rohamid/h743-lcd-dev/doc/H743_LCD_dev.pdf

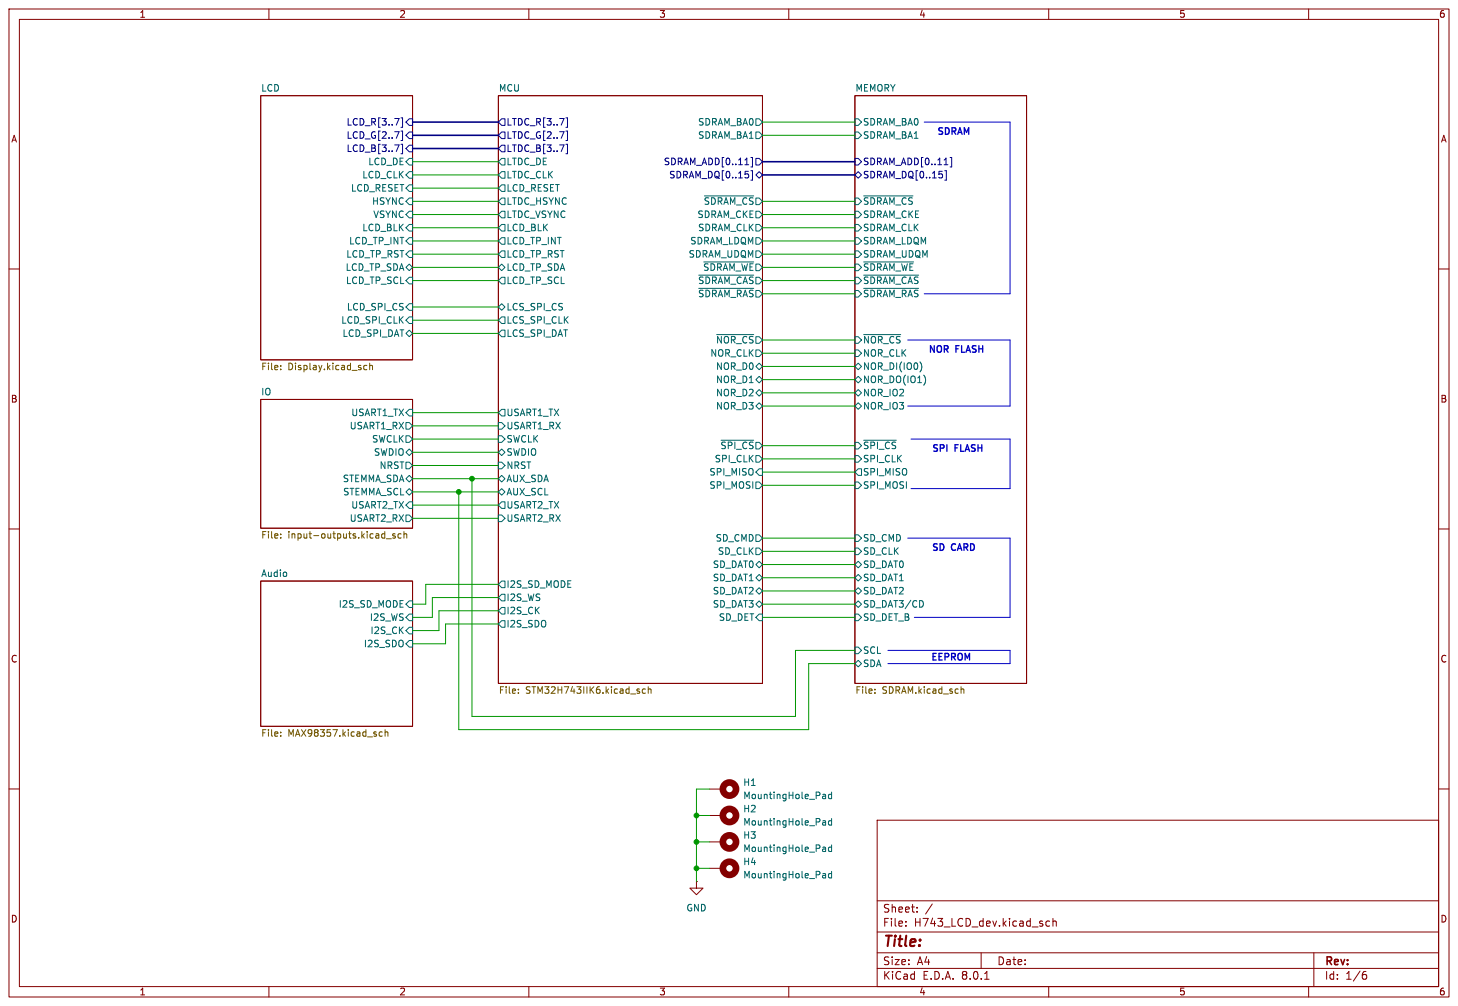
[picture p1: page 1]

Id: 1/6 Title: File: H743_LCD_dev.kicad_sch Sheet: /

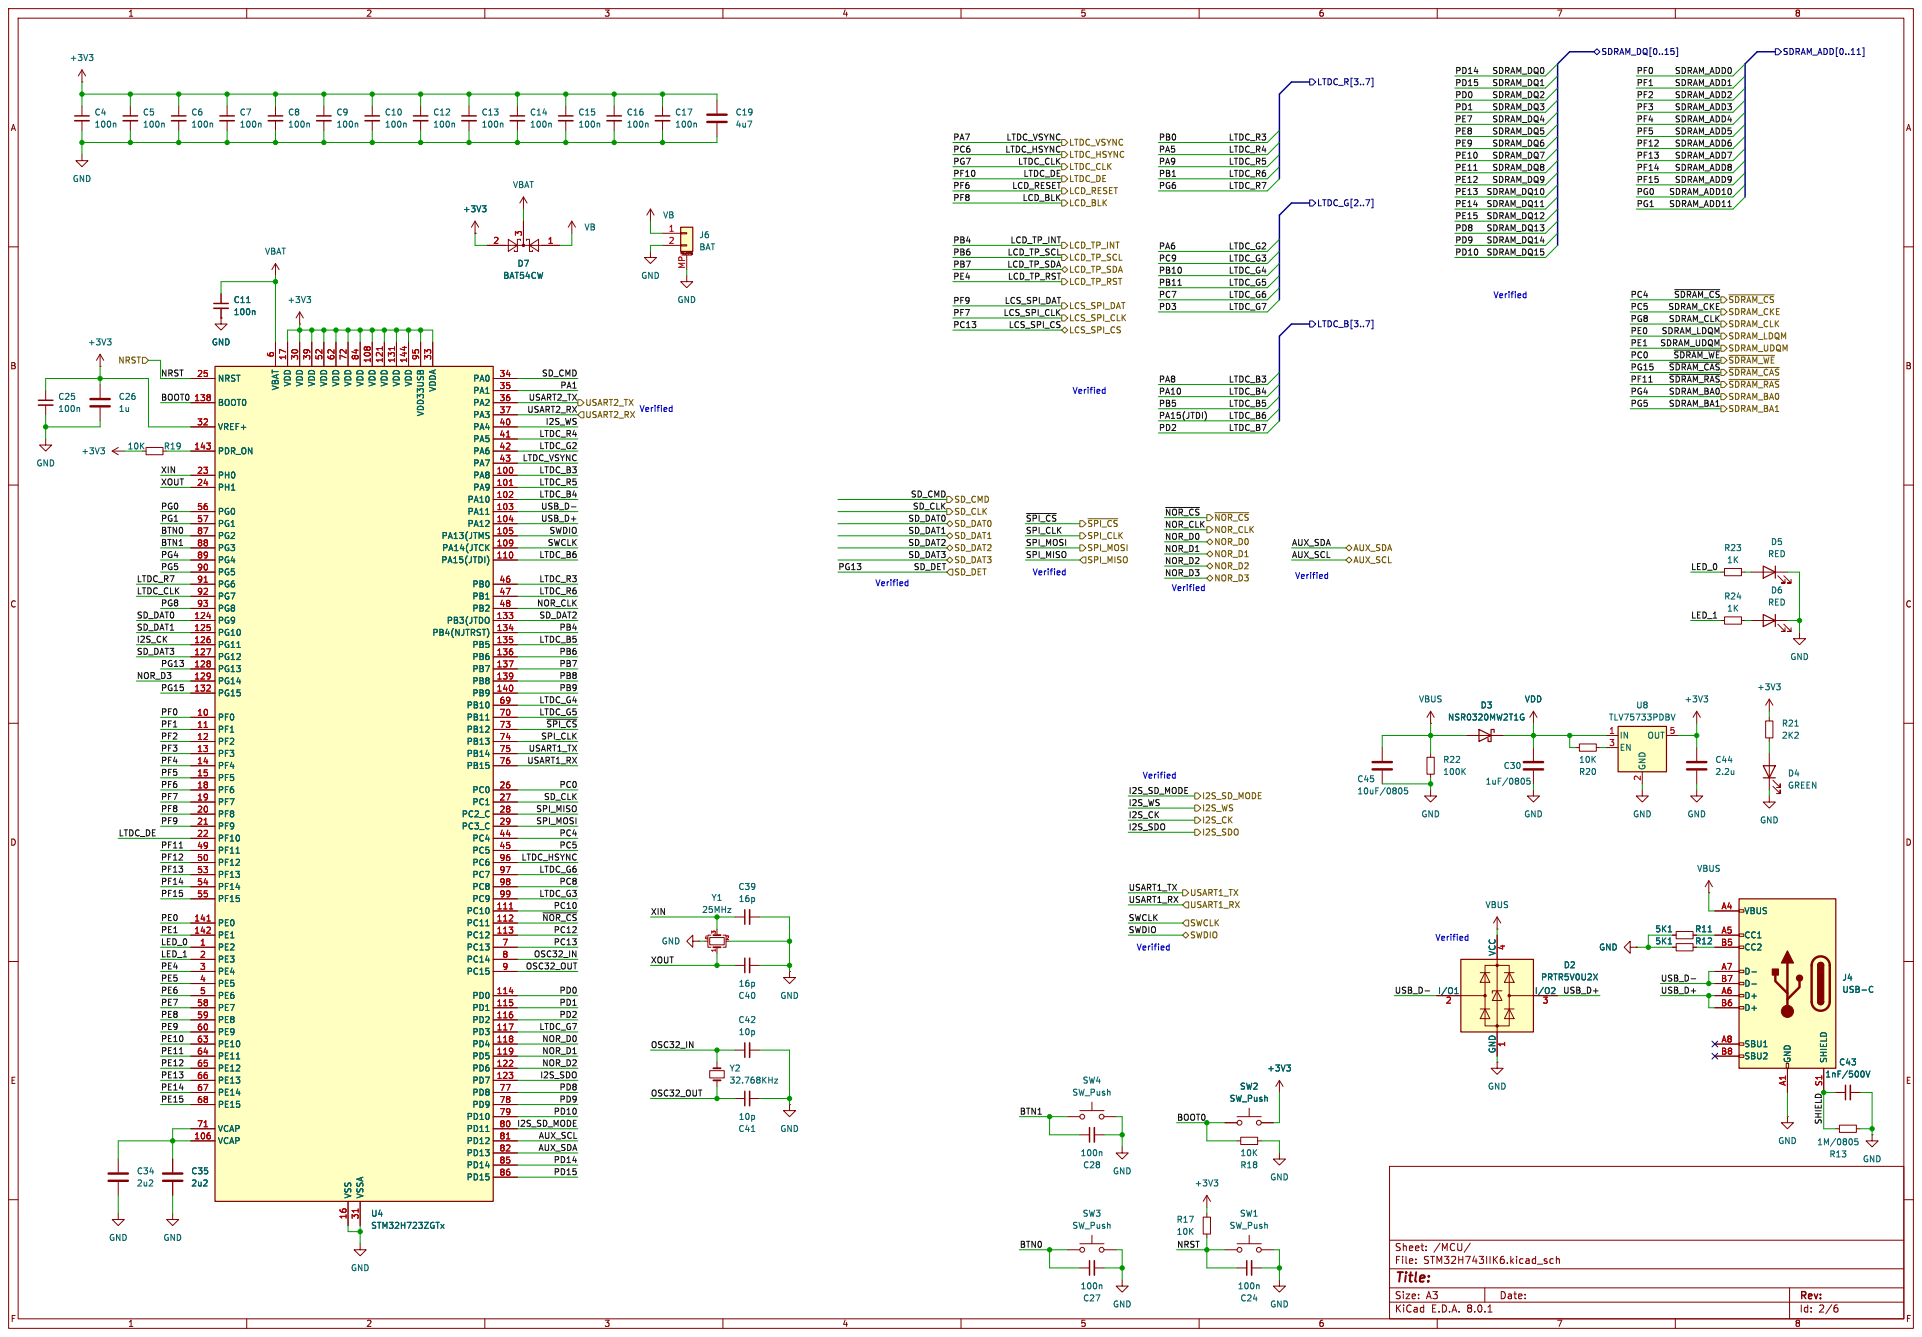
[picture p2: page 2]

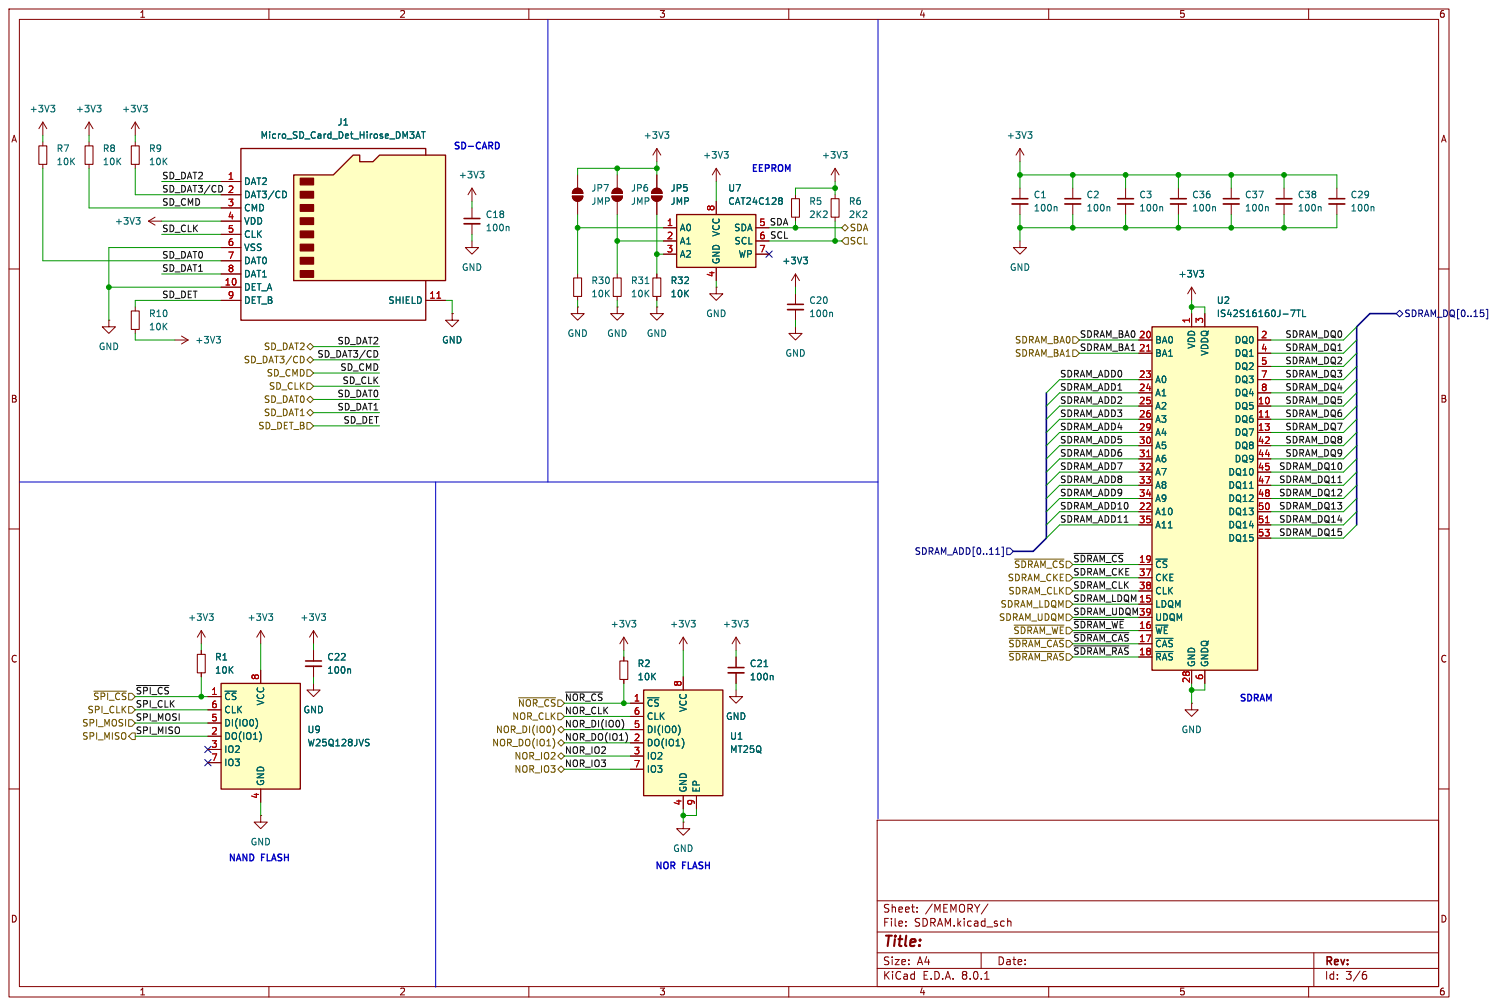
[picture p3: page 3]

4 SDA 5 SCL 6 WP 7 VCC

3 A5 30 A6 31 A7 32 A8 33 A9 34 A11 35 CKE 37 CLK 38 UDQM 39 DQ1 4 DQ8 42 DQ9 44 DQ10 45 DQ11 47 DQ12 48 DQ2 5 DQ13 50 DQ14 51 DQ15 53 GNDQ

Id: 3/6 Title: File: SDRAM.kicad_sch Sheet: /MEMORY/

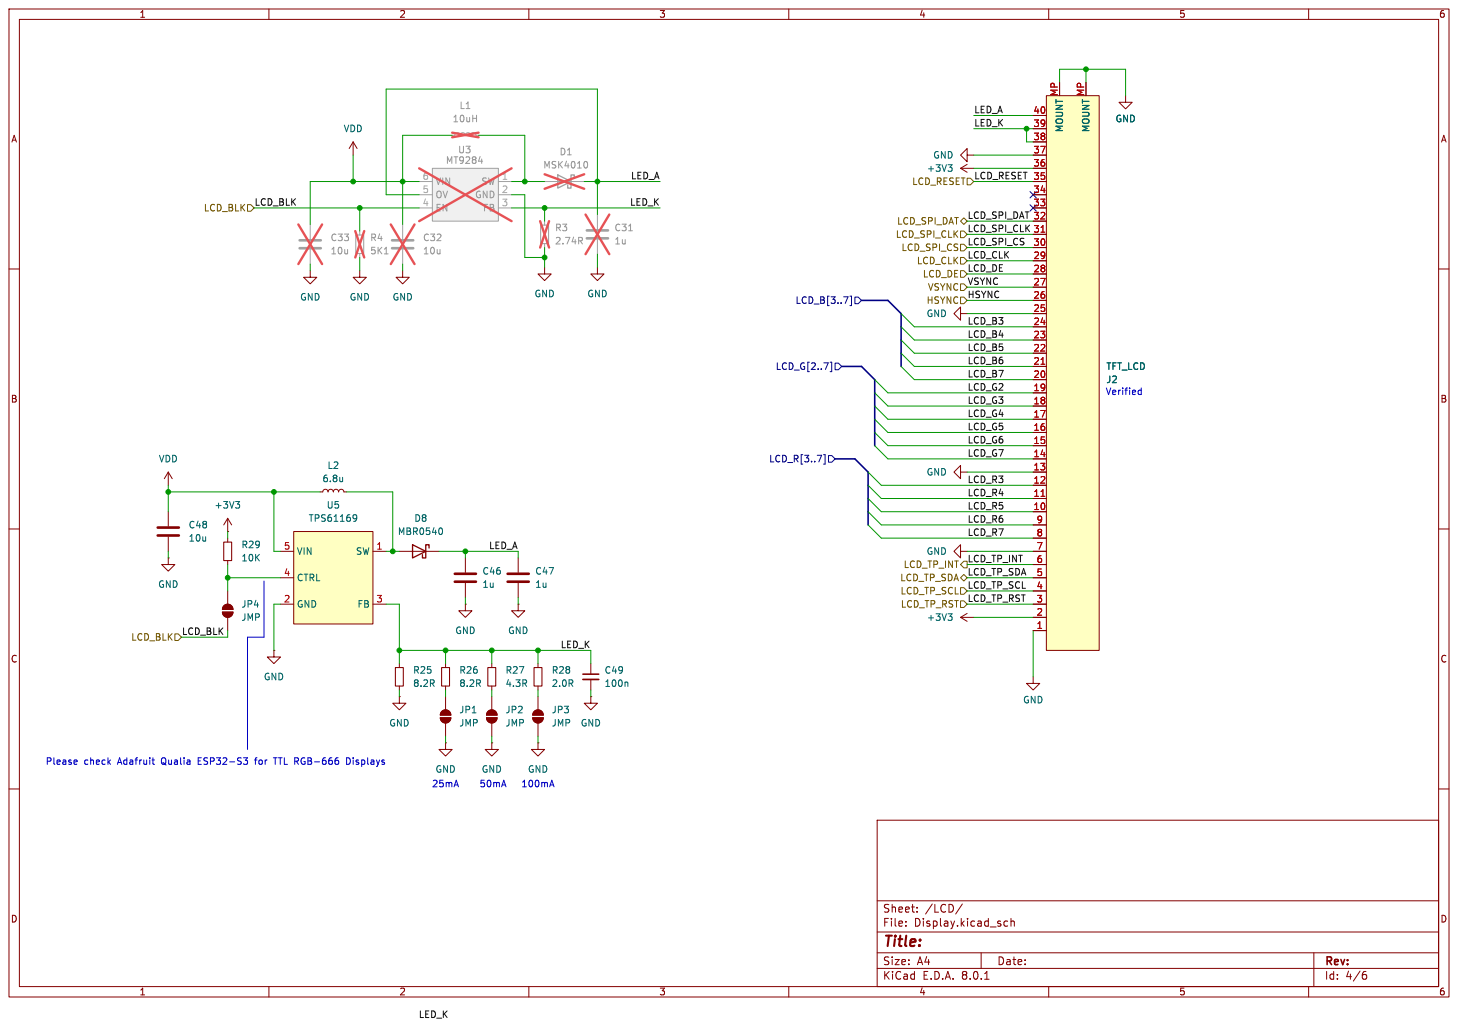
[picture p4: page 4]

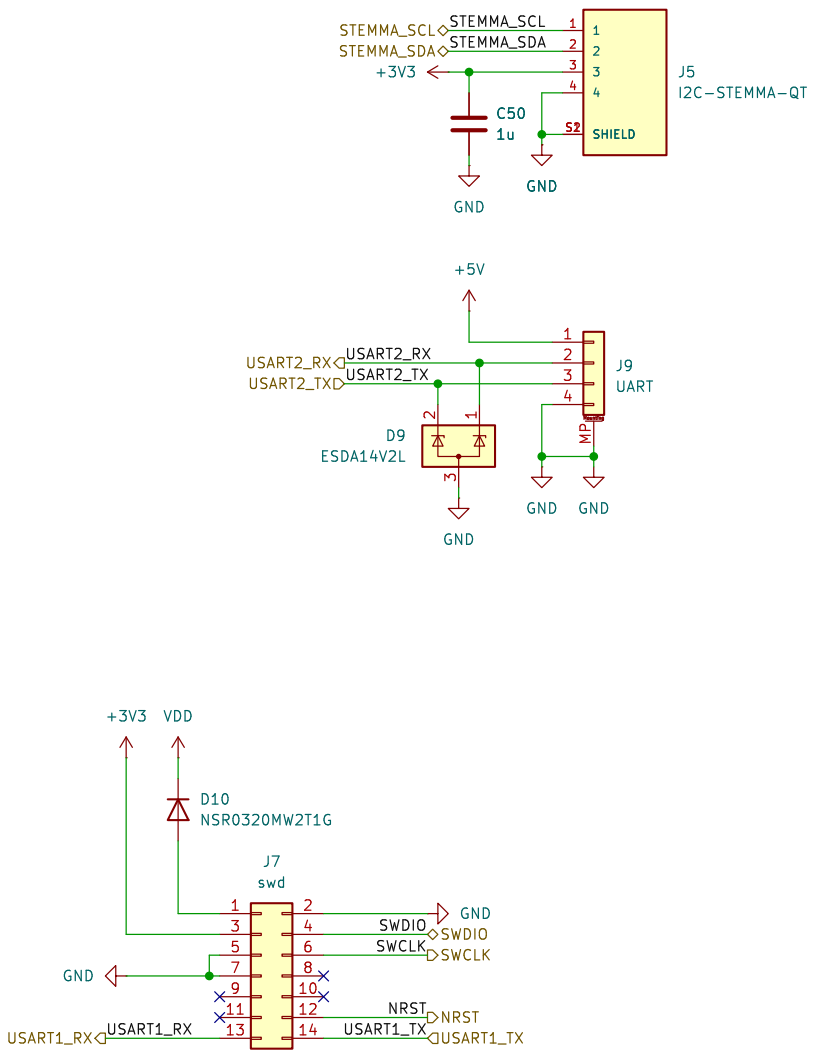
[picture p5: page 5]

Id: 5/6 Title: File: input-outputs.kicad_sch Sheet: /IO/

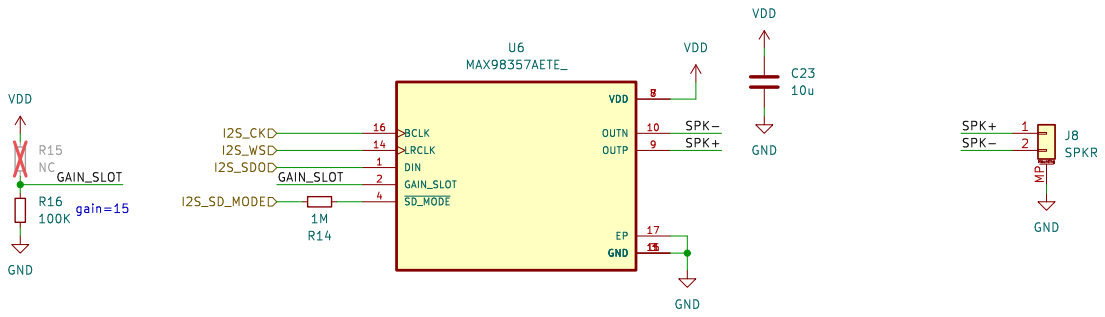
[picture p6: page 6]

Id: 6/6 Title: File: MAX98357.kicad_sch Sheet: /Audio/ GND
