rohamid/h743-lcd-dev/doc/STM32U5G9ZJT6Q Discovery.pdf

Title: Project_Overview

Size:

Reference:
A4 | Sheet: | of

Revision:

Project: STM32U5G9ZJT6Q Discovery

C 01 | MB1918
2023-07-05

U5G9ZJQ

Date:

Variant:

Table of contents | Legend

General comment such as function title, configuration, ...

Text to be added to silkscreen.

# STM32U5G9ZJT6Q Discovery

MB1918

Warning text.

# Open Platform License Agreement

The Open Platform License Agreement (“Agreement”) is a binding legal contract between you ("You")

and STMicroelectronics International N.V. (“ST”), a company incorporated under the laws of the

Netherlands acting for the purpose of this Agreement through its Swiss branch 39, Chemin du

Champ des Filles, 1228 Plan-les-Ouates, Geneva, Switzerland.

By using the enclosed reference designs, schematics, PC board layouts, and documentation, in hardcopy

or CAD tool file format (collectively, the “Reference Material”), You are agreeing to be bound by

the terms and conditions of this Agreement. Do not use the Reference Material until You have read

and agreed to this Agreement terms and conditions. The use of the Reference Material automatically

implies the acceptance of the Agreement terms and conditions.

The complete Open Platform License Agreement can be found on www.st.com/opla.

MB1918TOP

MB1918_TOP.SchDoc

Sheet 1: Project overview (this page)

Sheet 2: MB11918 TOP

Sheet 3: MCU System

Sheet 4: MCU Interfaces

Sheet 5: MCU Power

Sheet 6: Board Power

Sheet 7: Display

Sheet 8: USB Type C

Sheet 9: User Interface

Sheet 10: Octo SPI Flash Memory

Sheet 11: Arduino UNO Rev3Connectors

Sheet 12: STLINK V3EC

Sheet 13: External DebugConnectors

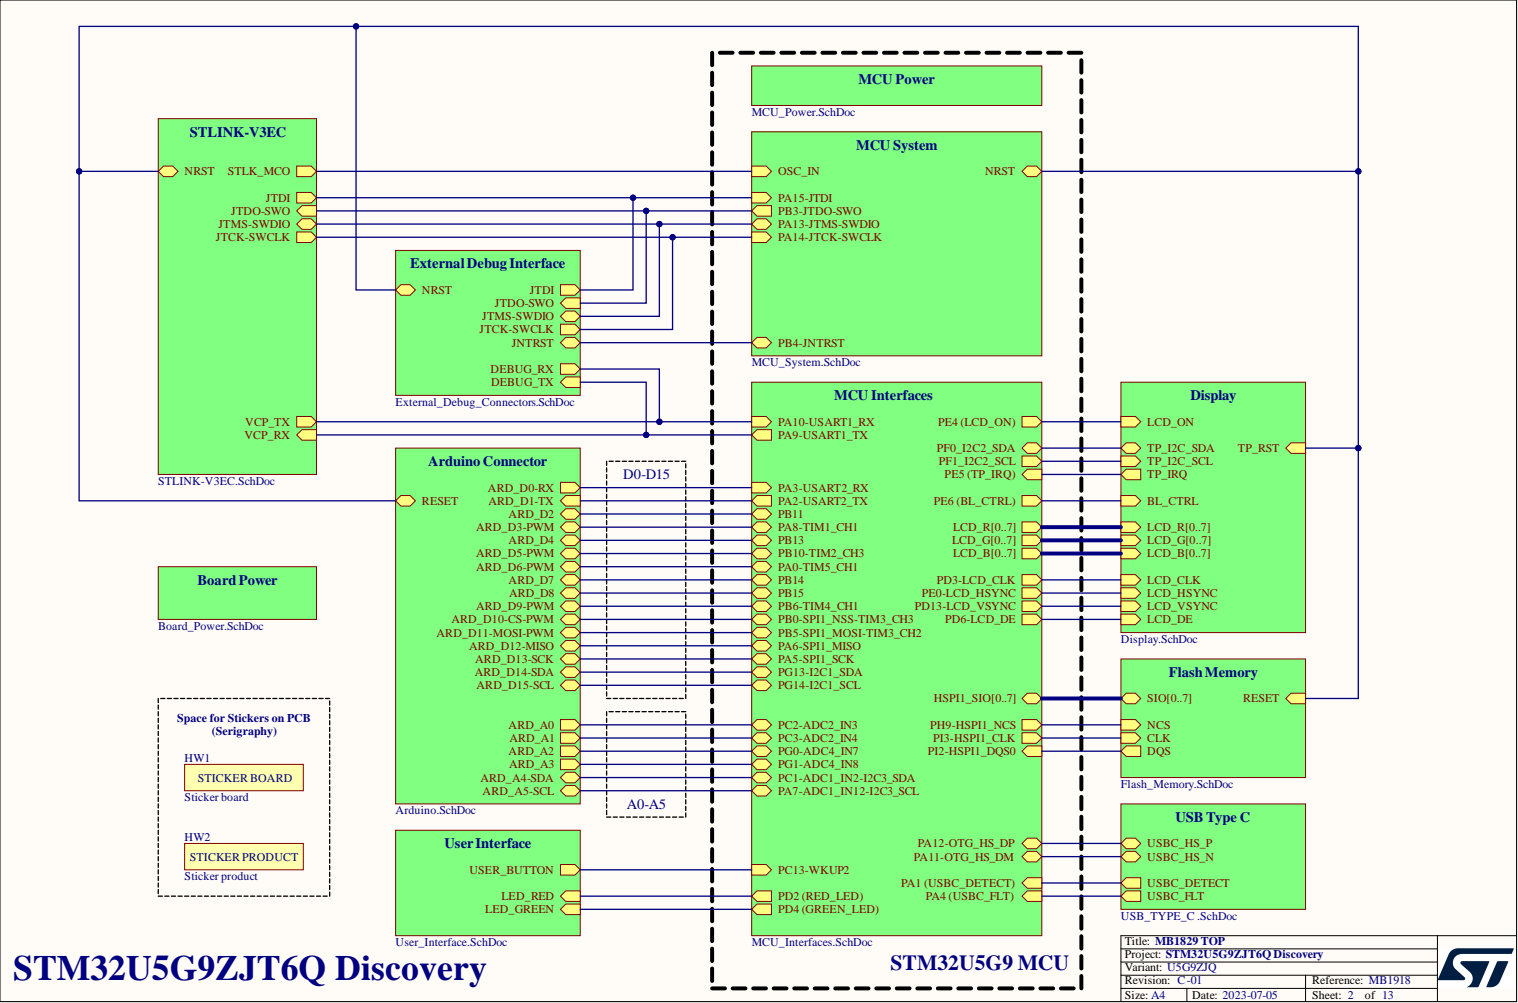
[picture p7: page 2]

Space for Stickers on PCB

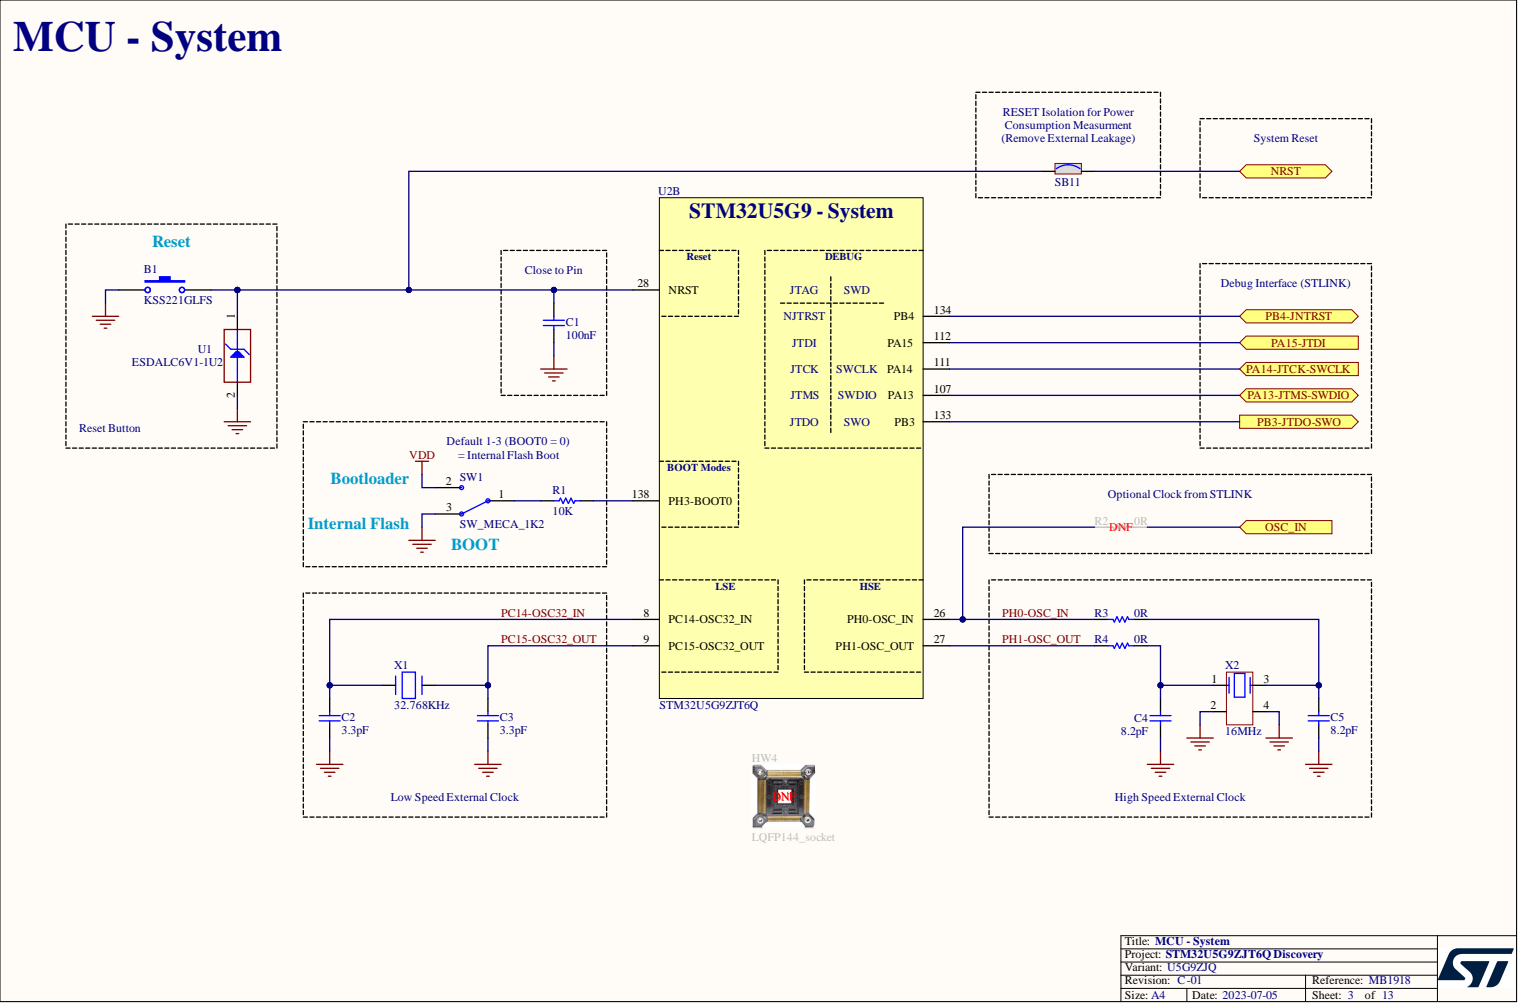
[picture p8: page 3]

RESET Isolation for Power
Consumption Measurment
(Remove External Leakage)

Optional Clock from STLINK

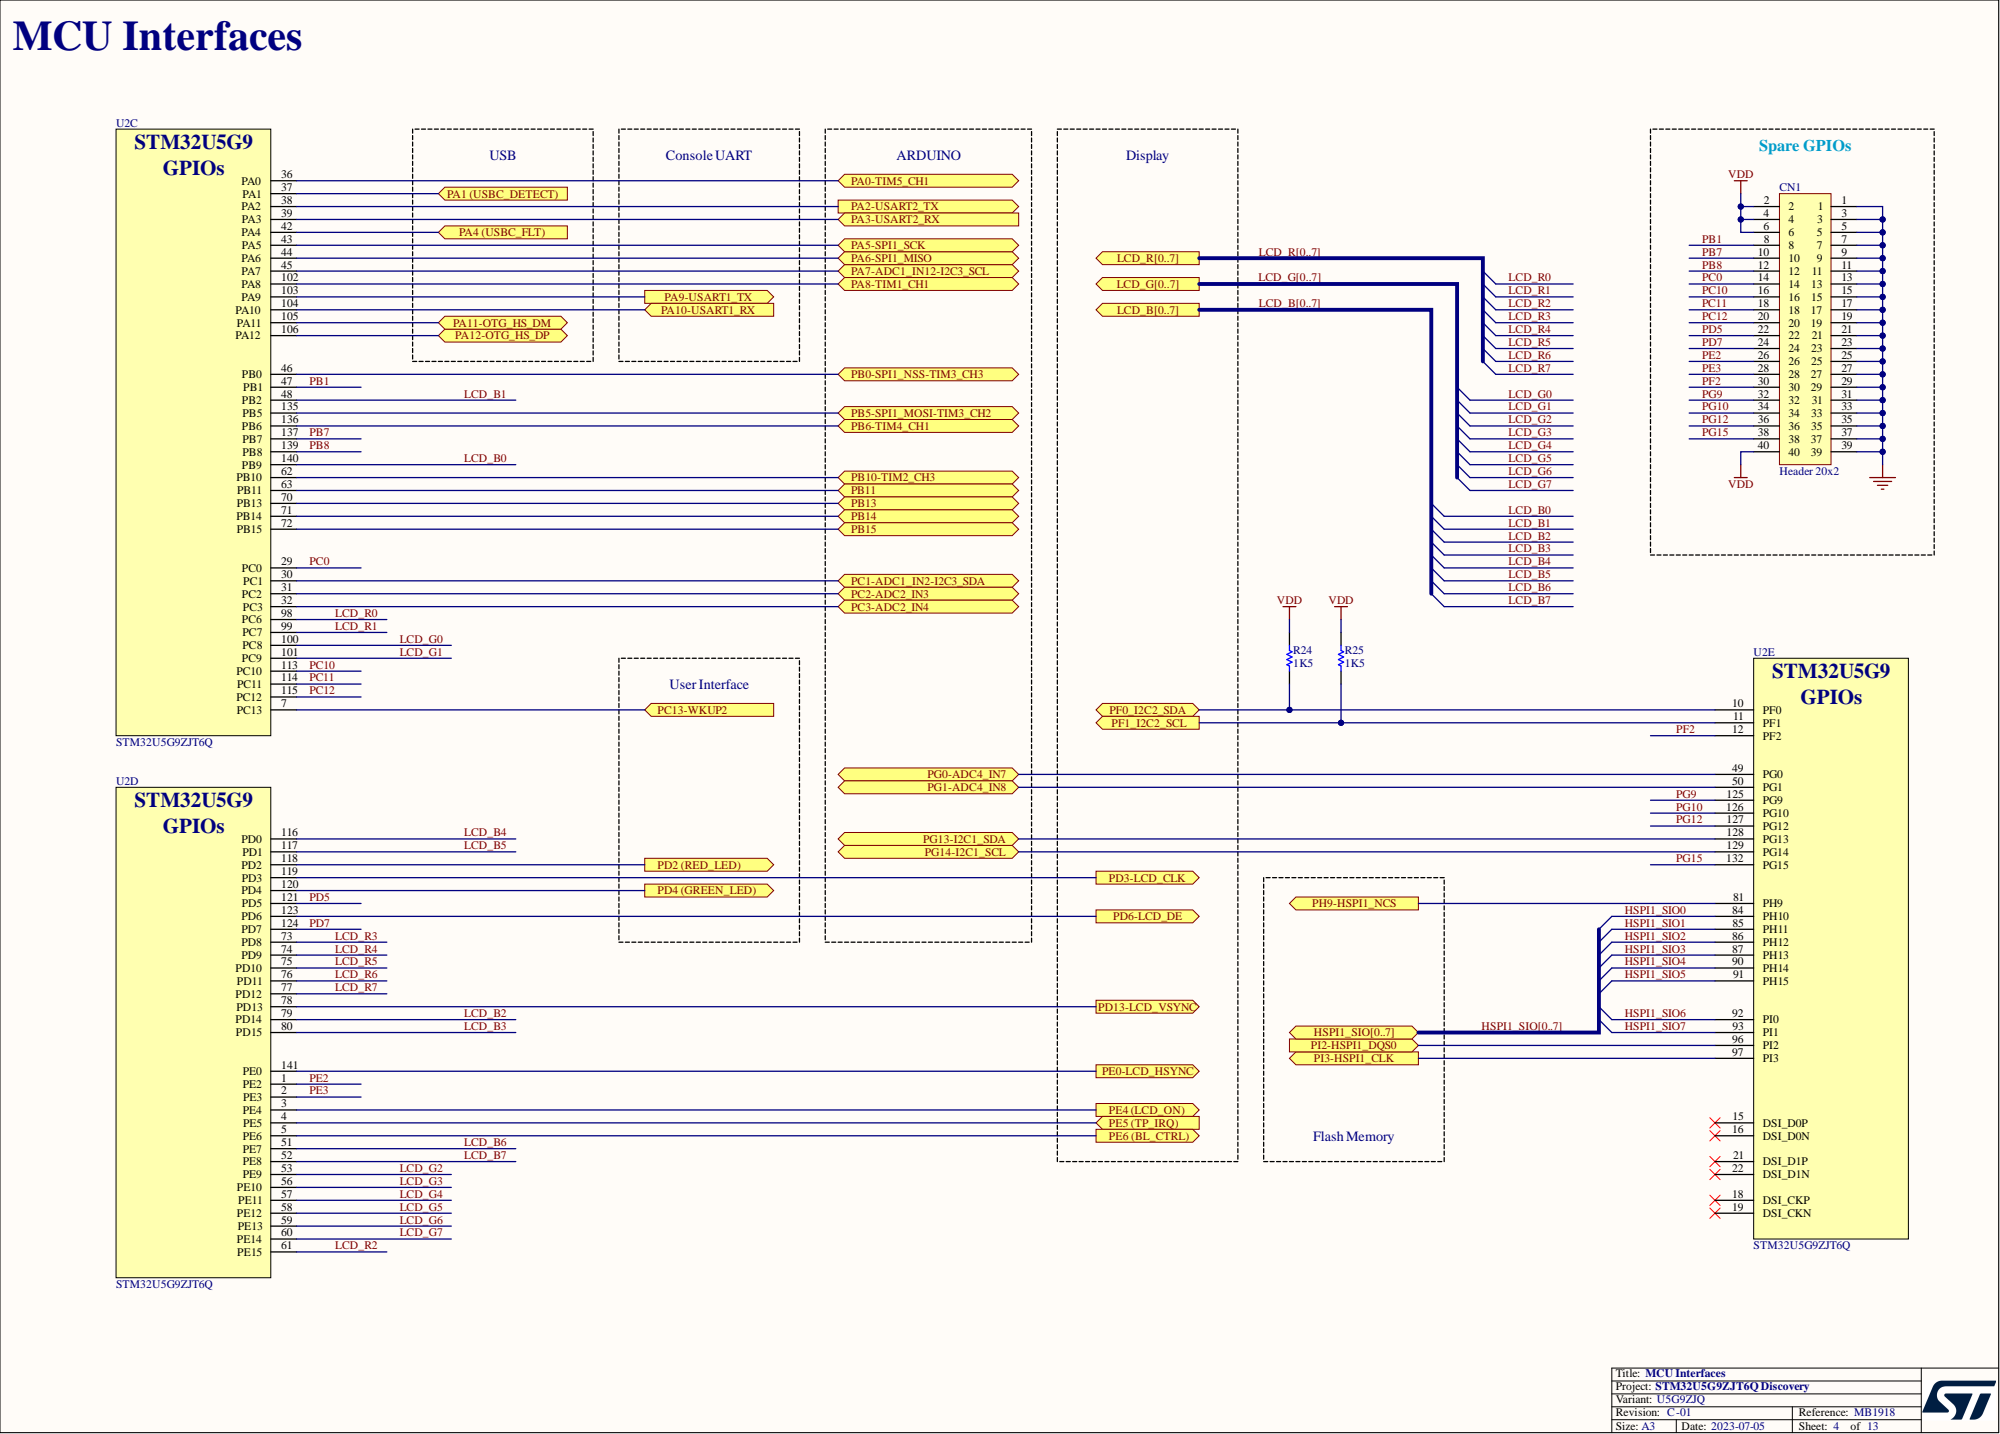
[picture p9: page 4]

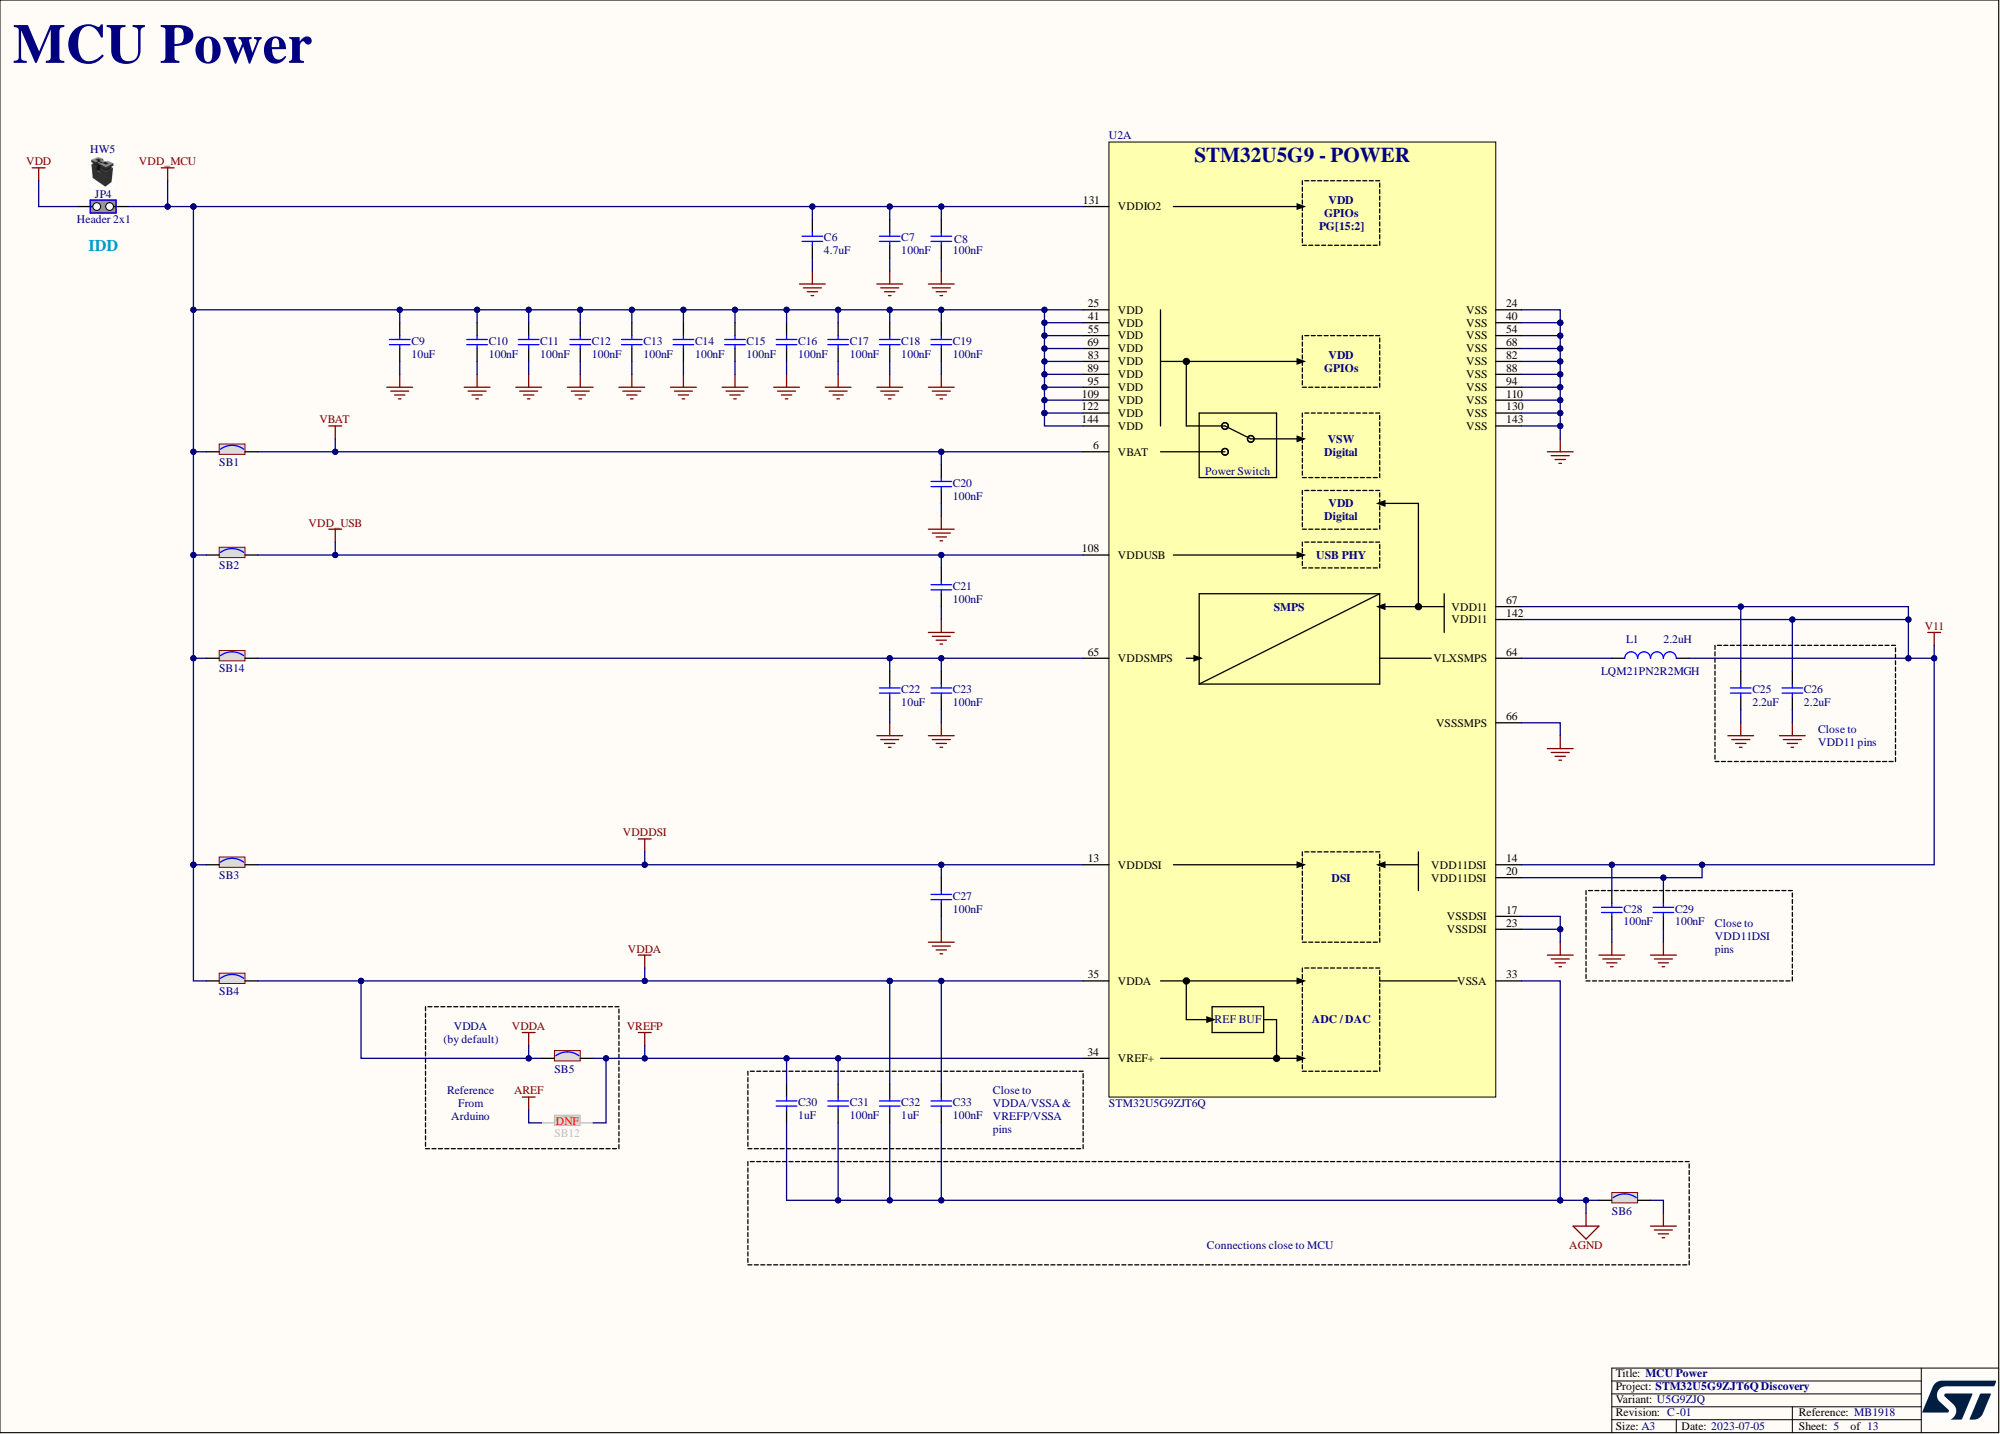
[picture p10: page 5]

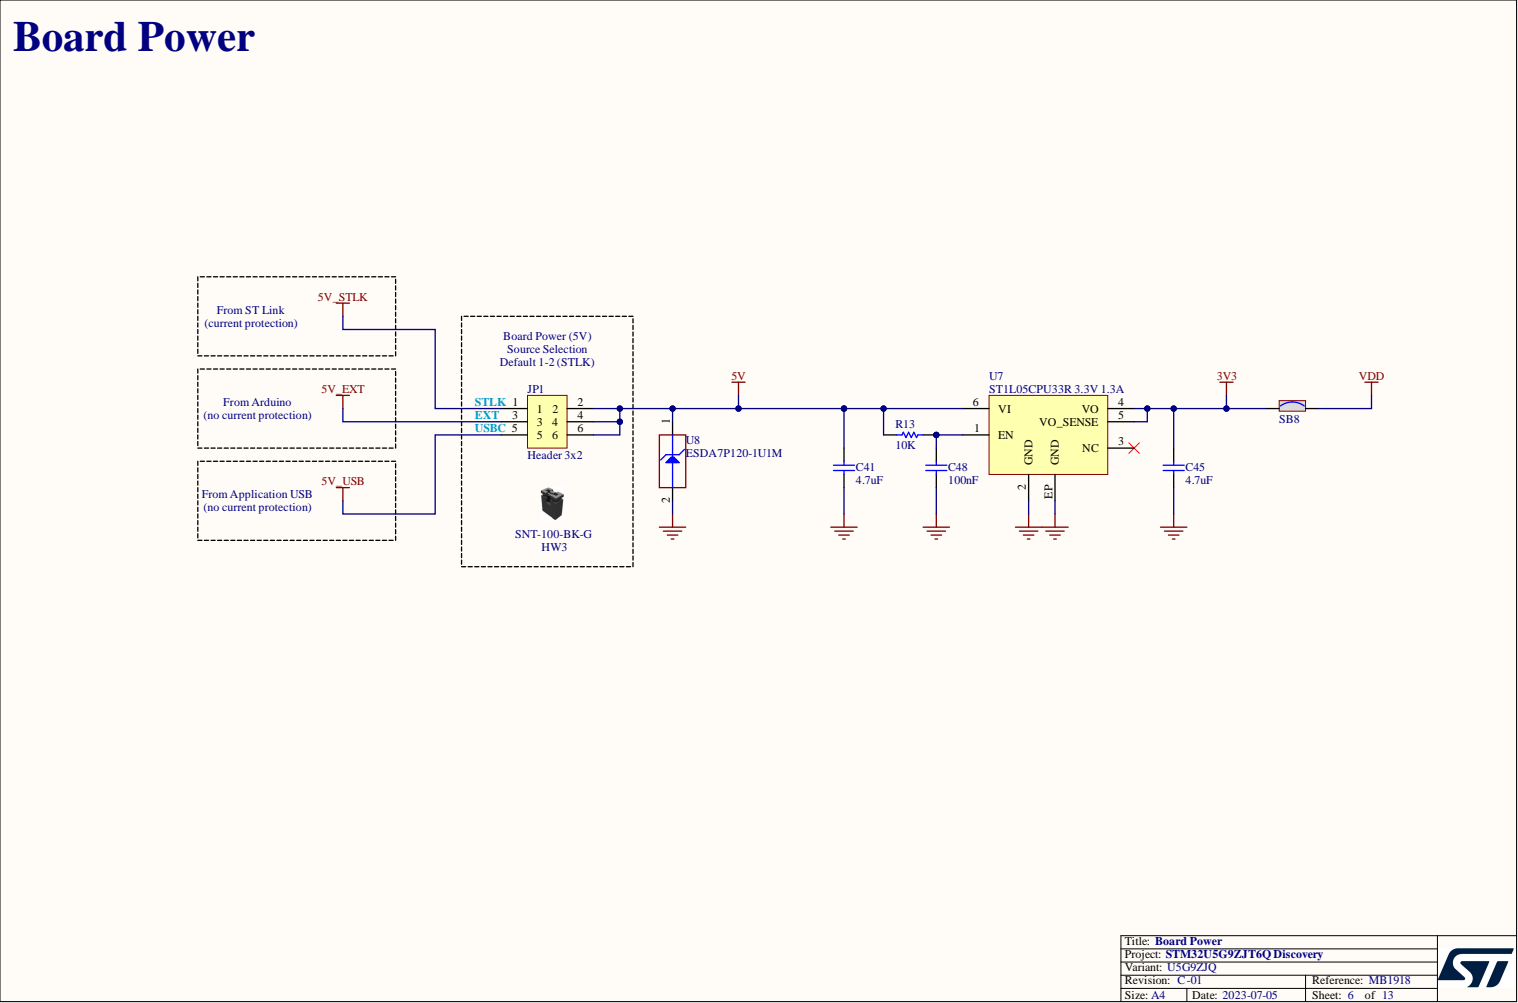
[picture p11: page 6]

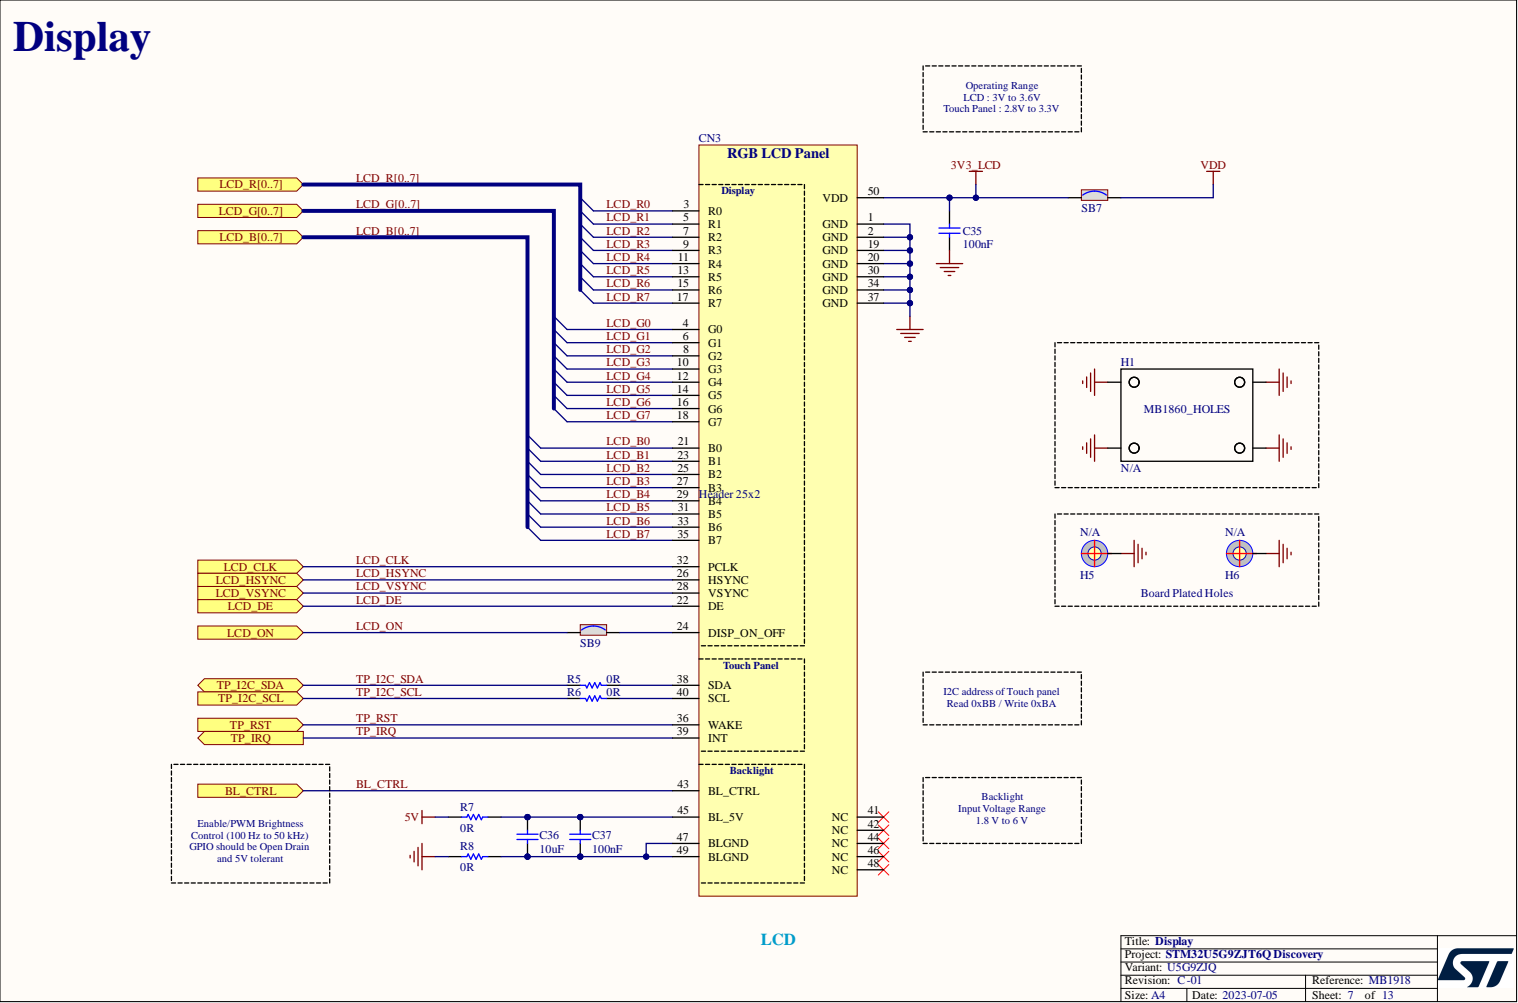
[picture p12: page 7]

PIO should be Open Dra
and 5V tol

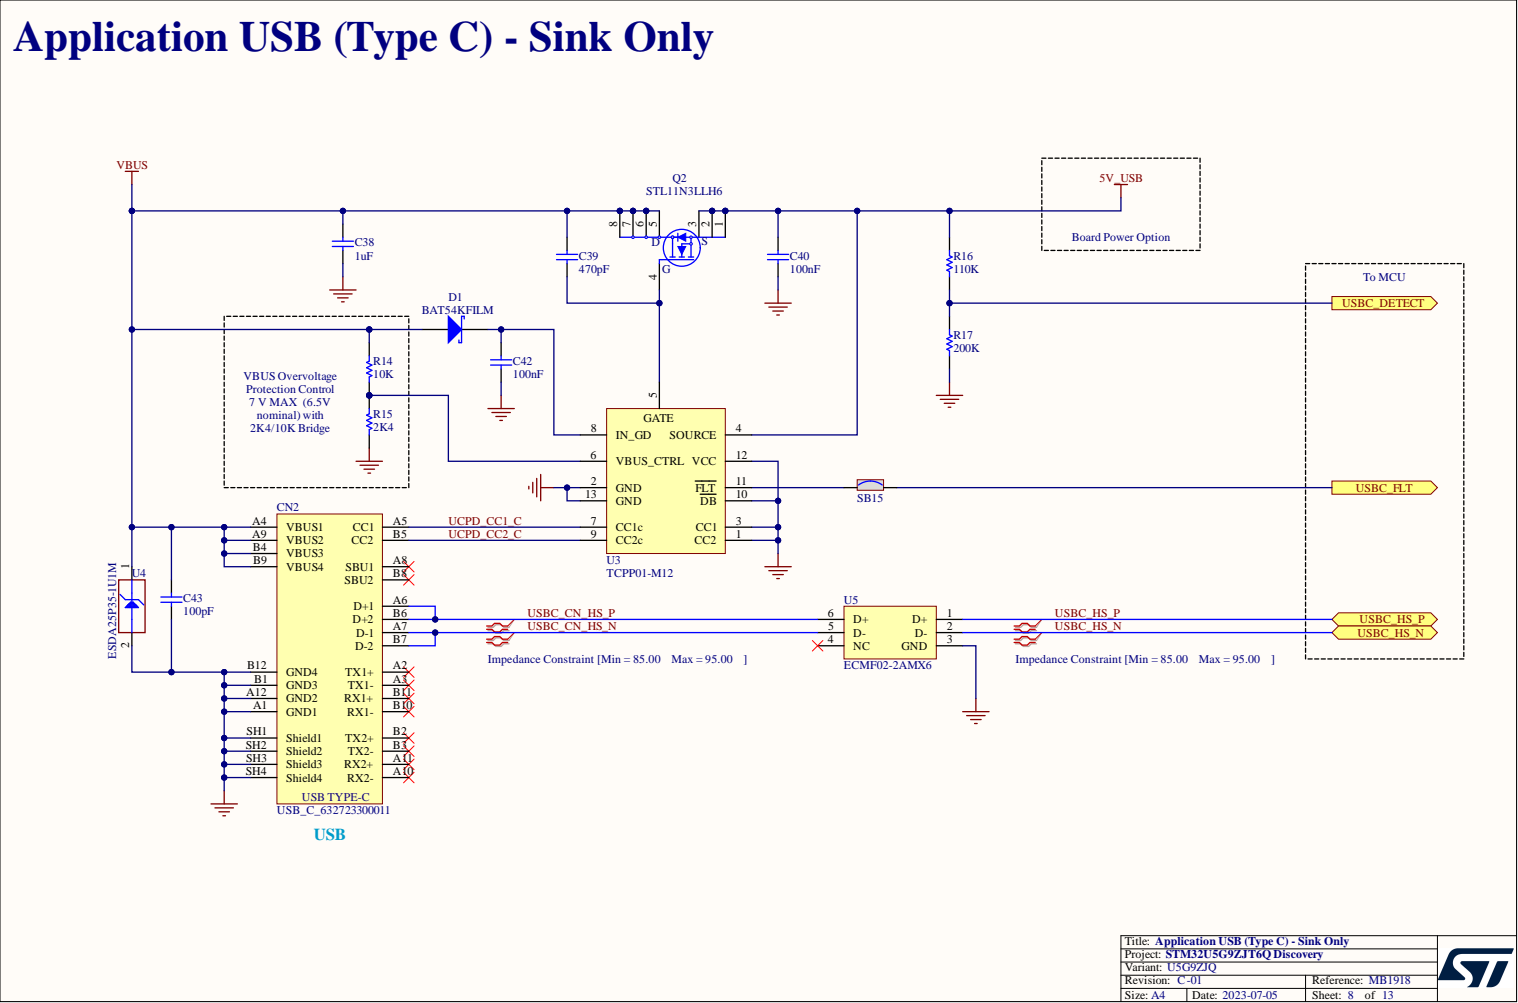
[picture p13: page 8]

Application USB (Type C) - Sink Only

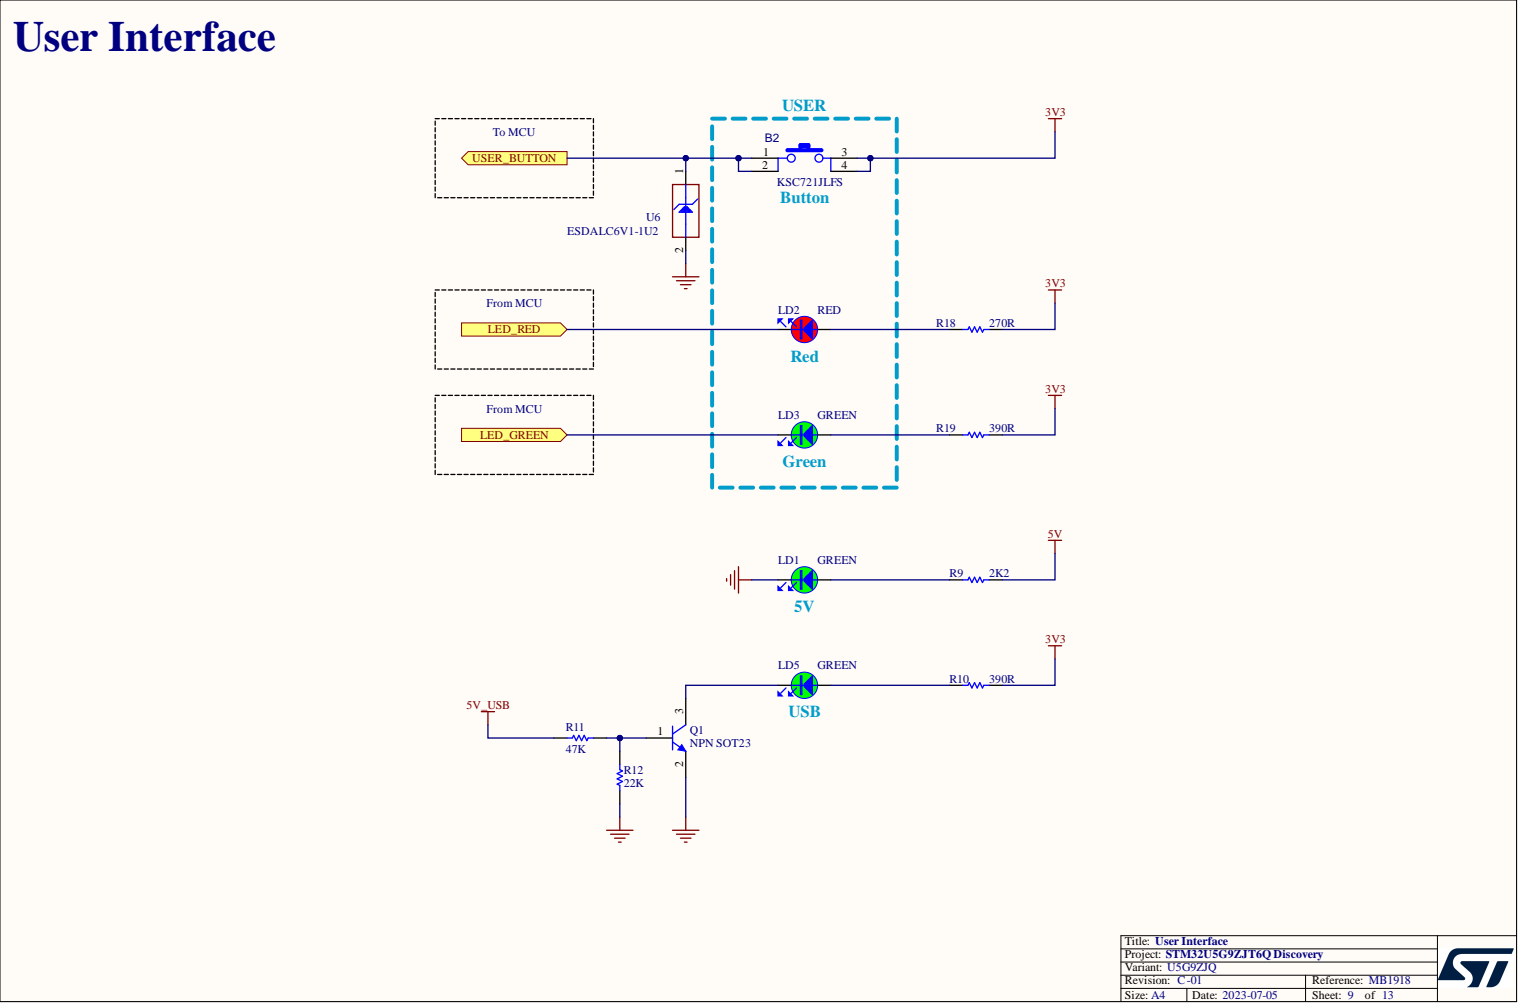
[picture p14: page 9]

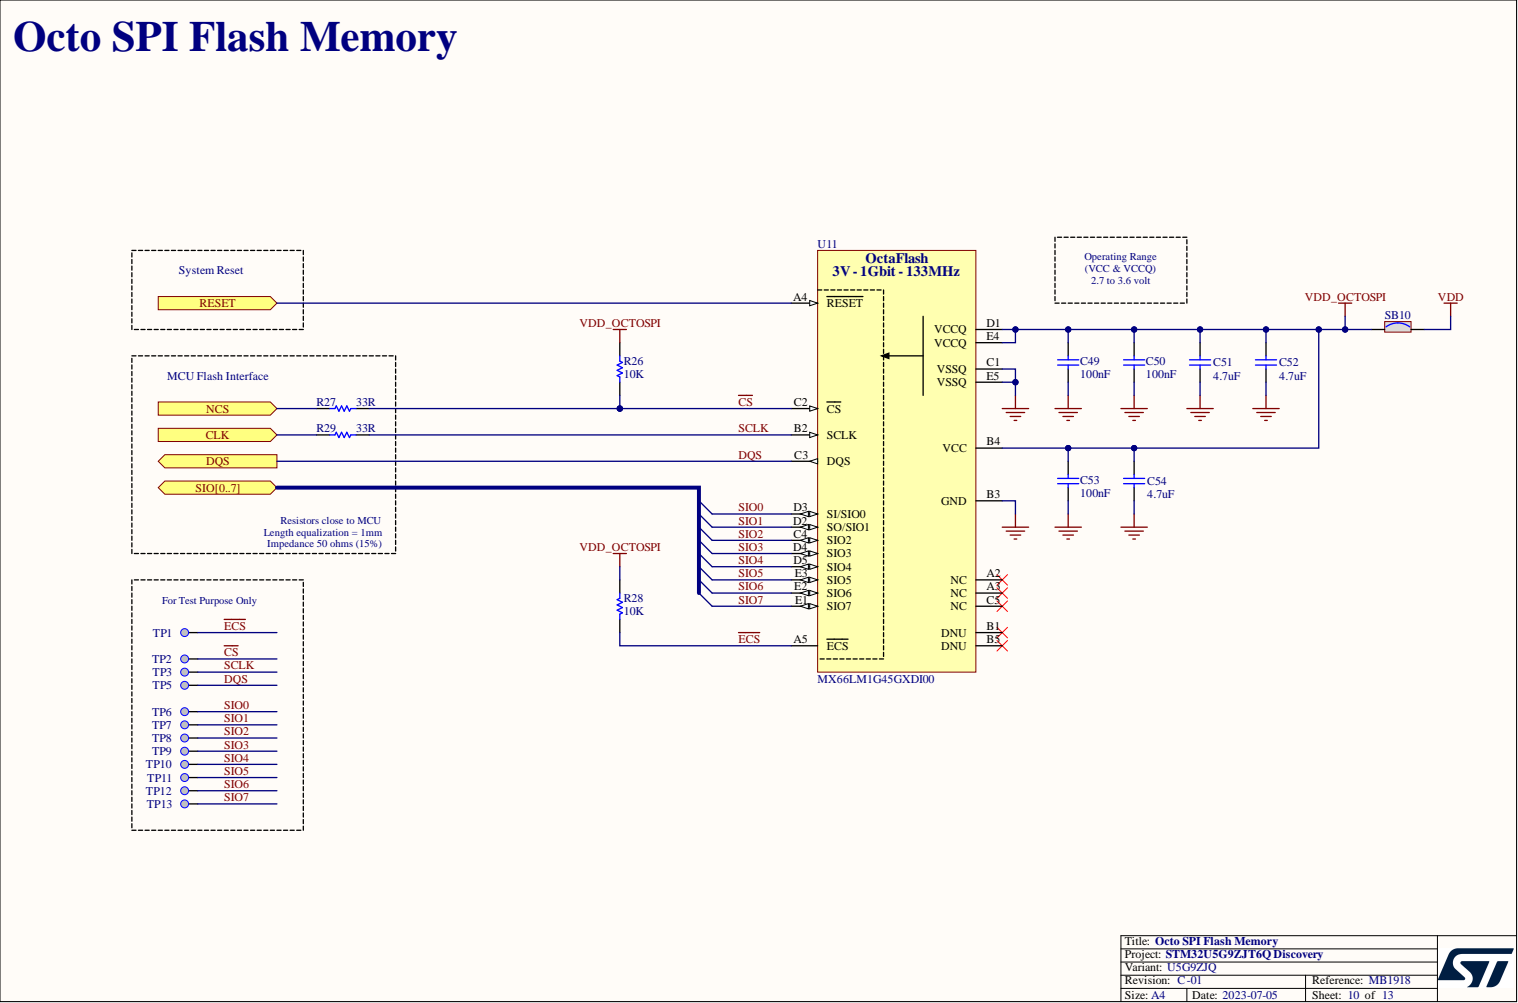
[picture p15: page 10]

Octo SPI Flash Memory

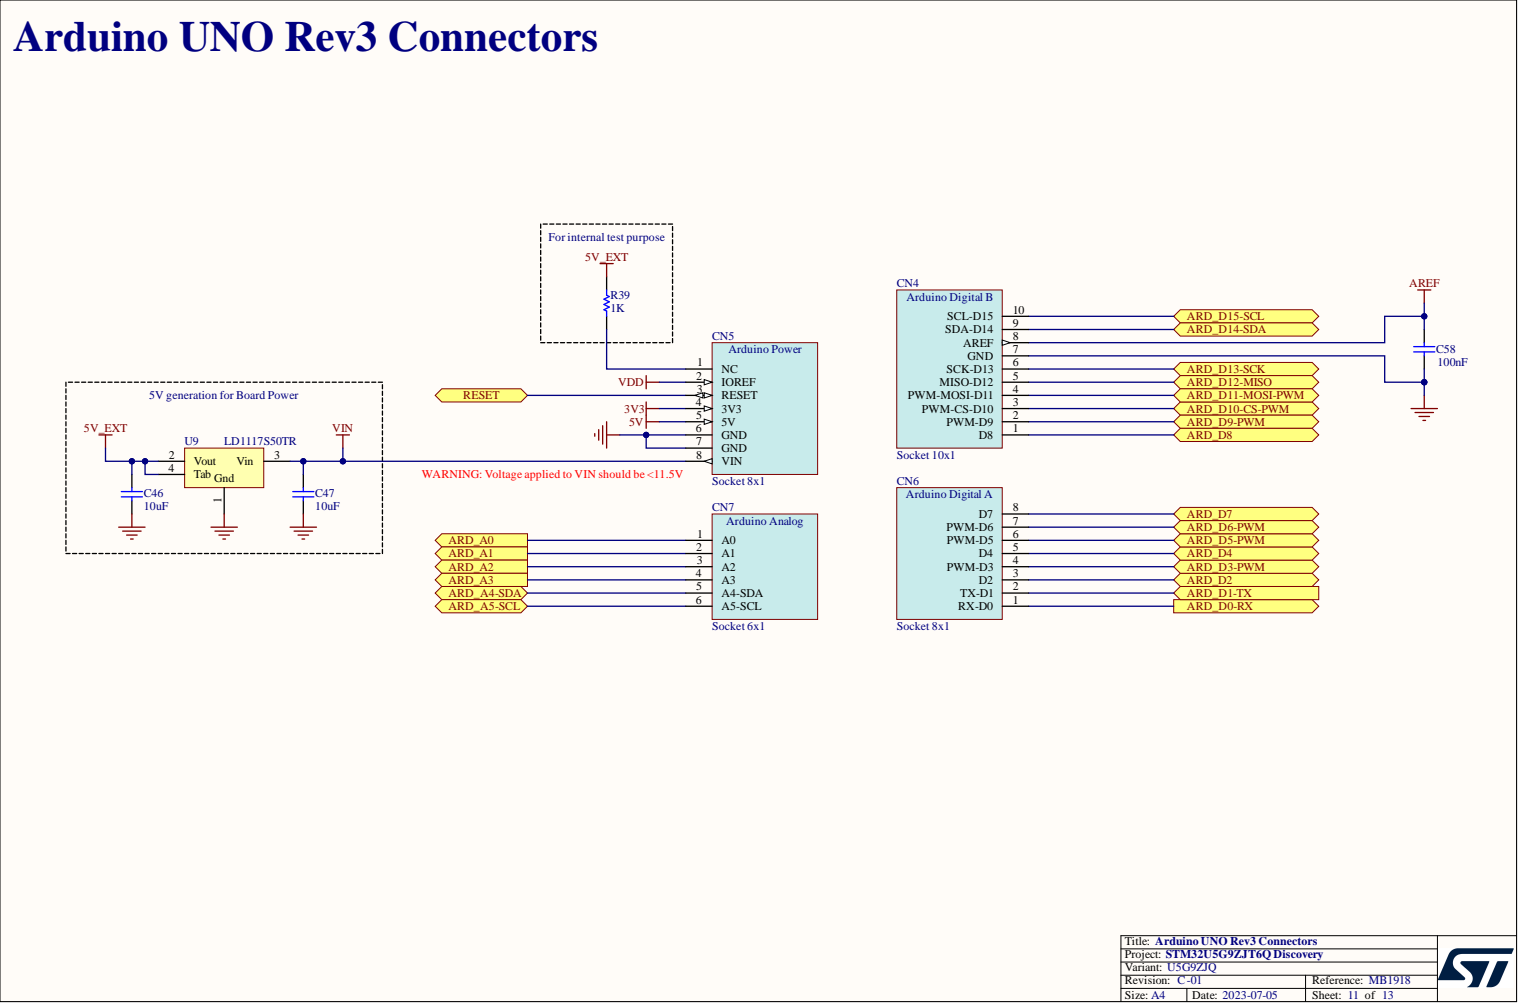
[picture p16: page 11]

Arduino UNO Rev3 Connectors ARD_A0 ARD_A4-SDA ARD_A5-SCL ARD_A1 ARD_A2 ARD_A3

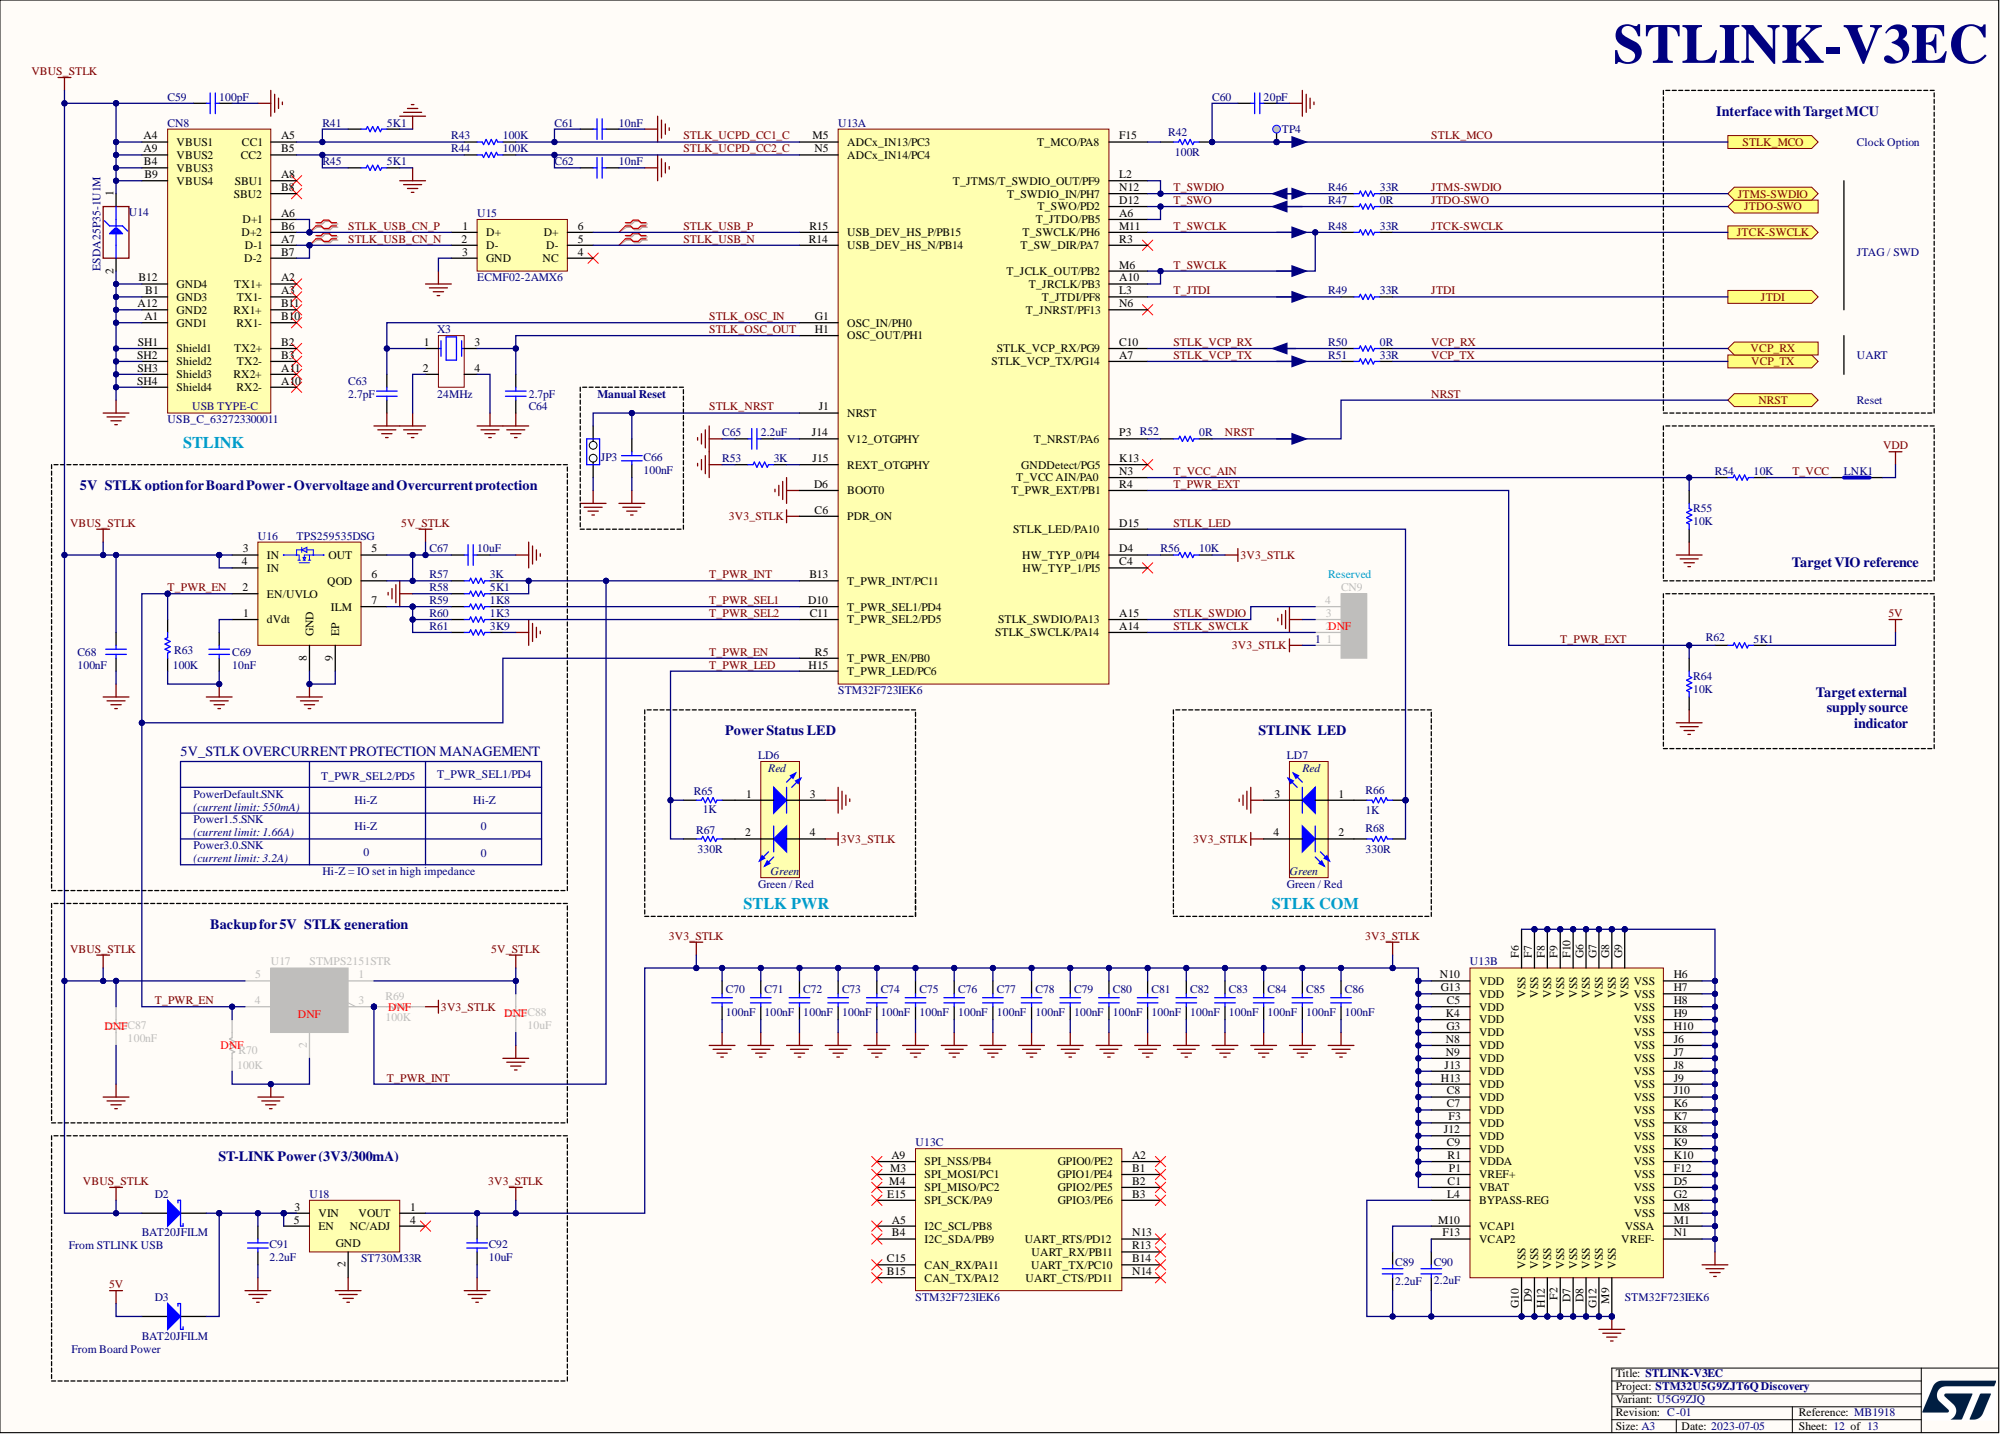
[picture p17: page 12]

VBUS2 A9 | R44 100K STLK_UCPD_CC2_C | ADCx_IN14/PC4 N5

V12_OTGPHY J14

5V_STLK option forBoardPower - Overvoltage andOvercurrent protection

C68 | T_PWR_EN | IN 4 | R57 3K

Reserved CN9

R58 5K1 | | T_PWR_SEL1 | T_PWR_SEL1/PD4 D10
R60 | 1K3 | T_PWR_SEL2 | T_PWR_SEL2/PD5 C11 | | | 1 1 2 2 3 3 4 4

R61 | 3K9 | | T_PWR_EN | T_PWR_EN/PB0 R5 | | STLK_SWCLK | DNF

PowerDefault.SNK (current limit: 550mA) | Hi-Z | Hi-Z

Power1.5.SNK (current limit: 1.66A) | Hi-Z | 0

Hi-Z = IO set in high impedance

VSS M9 VSS G12 VSS D8 VSS D7 VSS F2 VSS H12 VSS D9 VSS F6

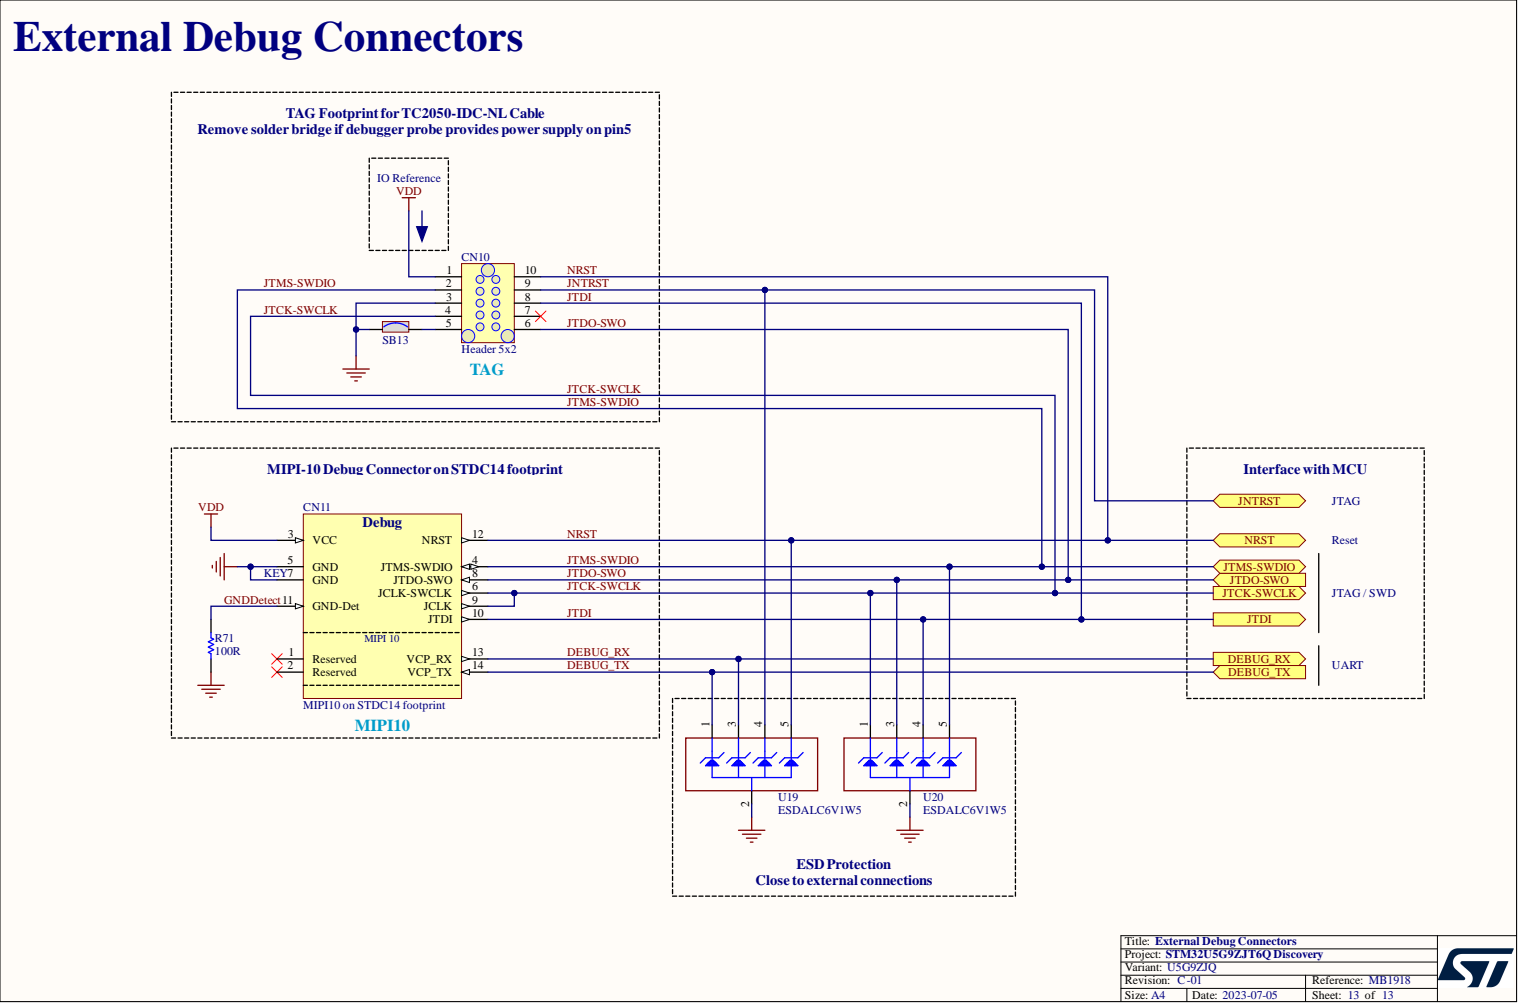
[picture p18: page 13]

TAG Footprint forTC2050-IDC-NL Cable

Remove solder bridge if debugger probe provides power supply on pin5

JNTRST

3 | | 8 | JTDI
5 | 6 | JTDO-SWO

MIPI-10 Debug Connector on STDC14 footprint

JTMS-SWDIO

KEY | JCLK-SWCLK JTDO-SWO | 6 GND 7 8 | JTDO-SWO

JTCK-SWCLK

JTDI MIPI 10 VCP_RX VCP_TX | 10 JCLK 9 GND-Det 11 | | JTDI

13 DEBUG_RX

Reserved 2 | 14 DEBUG_TX

Close to external connections

Title: External Debug Connectors
