rohamid/h743-lcd-dev/doc/SCH_MAIN_2023-08-08.pdf

VDD 72 PB12 73 PB13 74 PB14 75 PB15 76 PD8 77 PD9 78 PD10 79 PD11 80 PD12 81 PD13 82 VSS 83 VDD 84 PD14 85 PD15 86 PG2 87 PG3 88 PG4 89 PG5 90 PG6 91 PG7 92 PG8 93 VSS 94 VDD33USB 95 PC6 96 PC7 97 PC8 98 PC9 99 PA8 100 PA9 101 PA10 102 PA11 103 PA12 104 PA13 105 VCAP 106 VSS 107 VDD 108 PA14 109 PA15 110 PC10 111 PC11 112 PC12 113 PD0 114 PD1 115 PD2 116 PD3 117 PD4 118 PD5 119 VSS 120 VDD 121 PD6 122 PD7 123 PG9 124 PG10 125 PG11 126 PG12 127 PG13 128 PG14 129 VSS 130 VDD 131 PG15 132 PB3 133 PB4 134 PB5 135 PB6 136 PB7 137 BOOT0 138 PB8 139 PB9 140 PE0 141 PE1 142 PDR_ON 143 VDD 144

# SDRAM

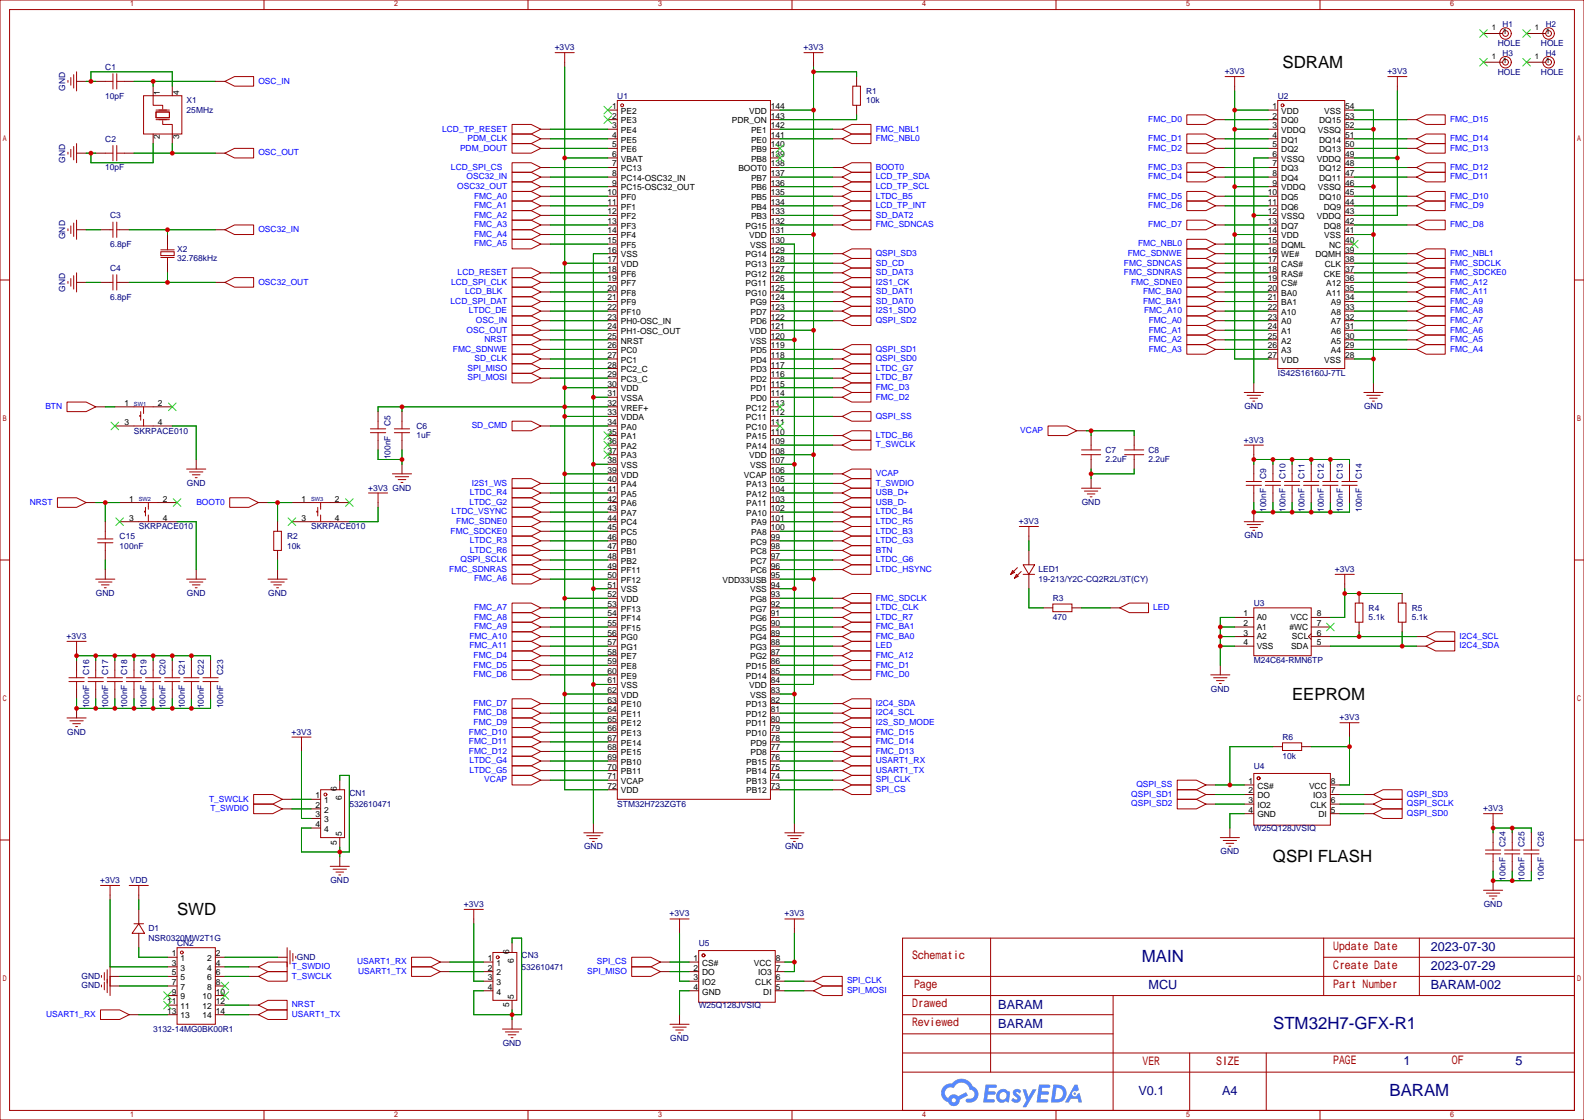
[picture p19: page 1]

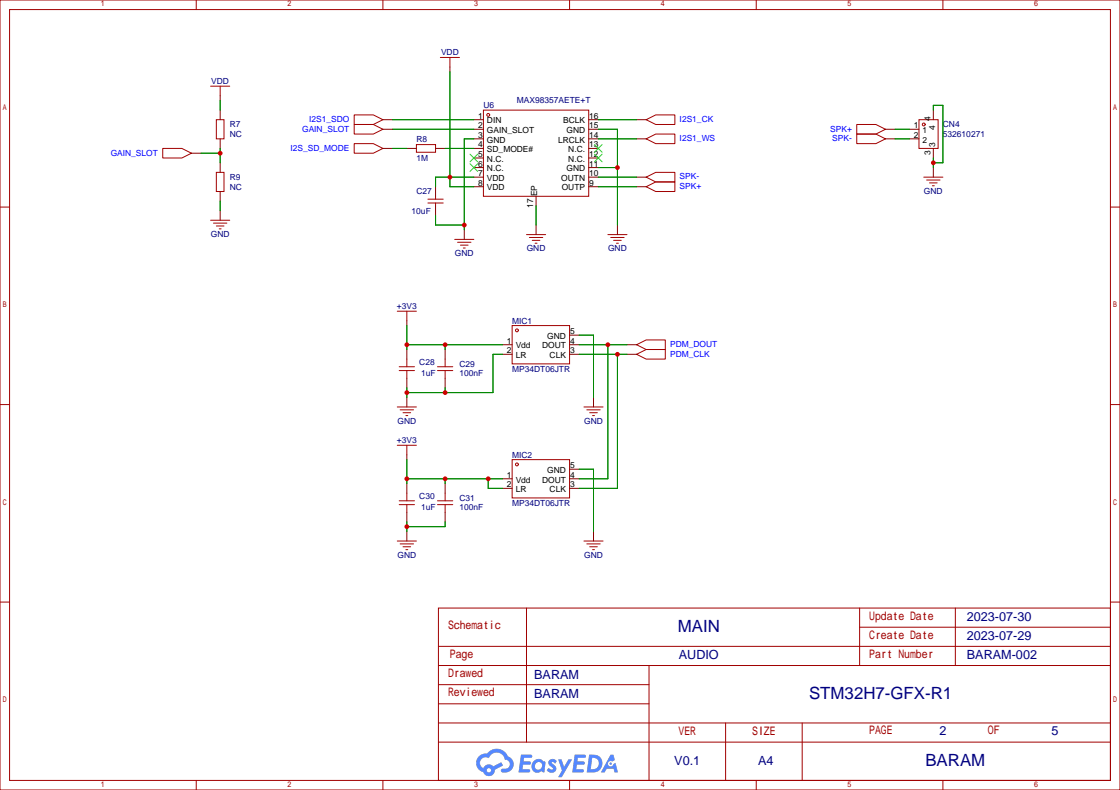
[picture p20: page 2]

OUTN 10 GND 11 N.C. 12 N.C. 13 LRCLK 14 GND 15 BCLK 16

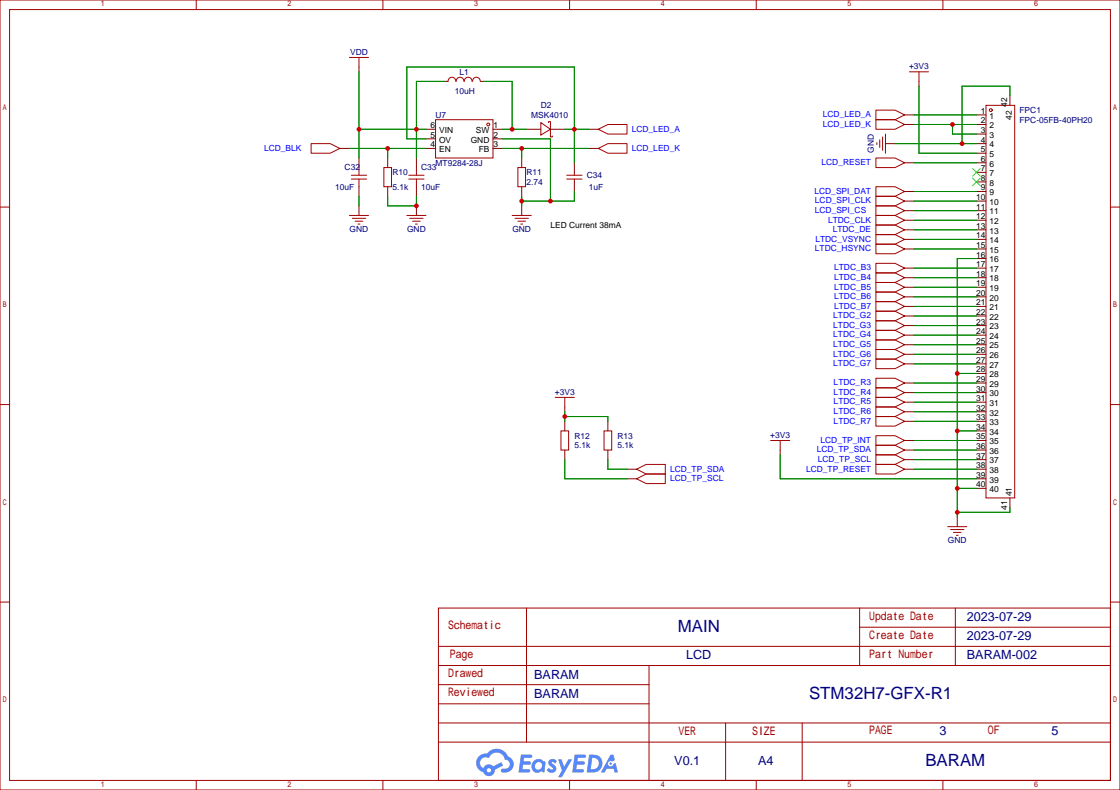
[picture p21: page 3]

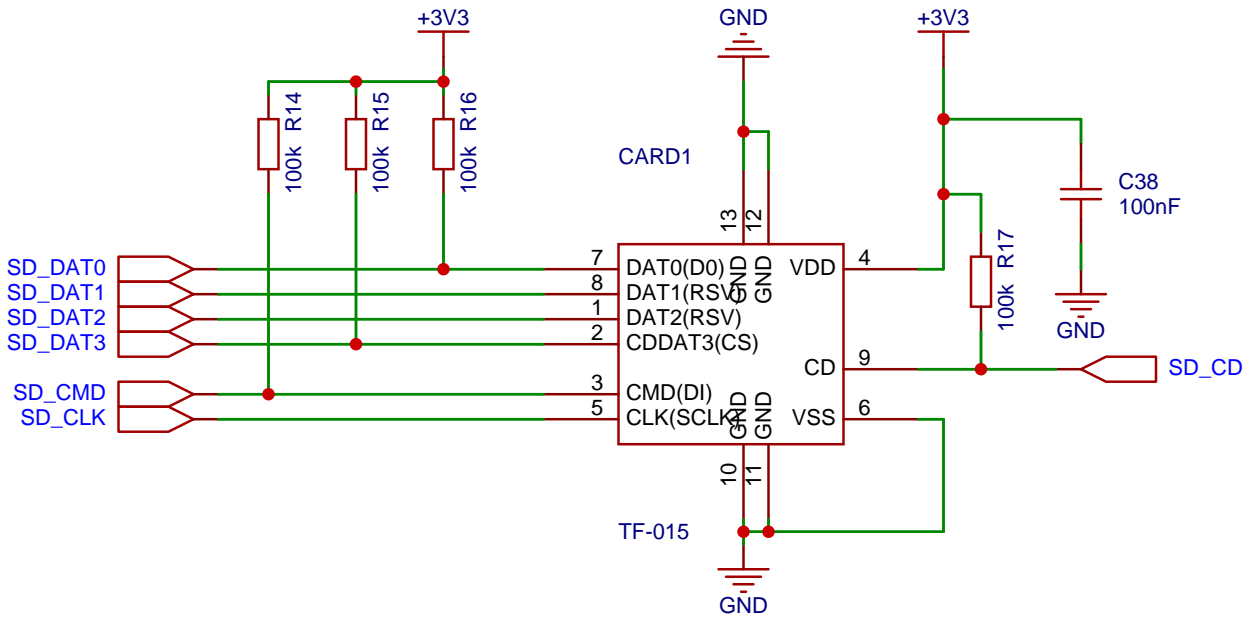
[picture p22: figure]
DAT2(RSV) 1 CDDAT3(CS) 2; CMD(DI) 3; VDD 4; CLK(SCLK) 5; VSS 6; DAT0(D0) 7; DAT1(RSV) 8; GND ¹³ GND 10; GND 11 GND 12; CARD1; GND; SD_DAT0 SD_DAT1 SD_DAT2 SD_DAT3; SD_CMD SD_CLK

Reviewed

Drawed

Create Date
Part Number

Schematic

Update Date

Page

## BARAM BARAM

# STM32H7-GFX-R1

2023-07-30

## 2023-07-29 MAIN

## BARAM-002

## SDCARD

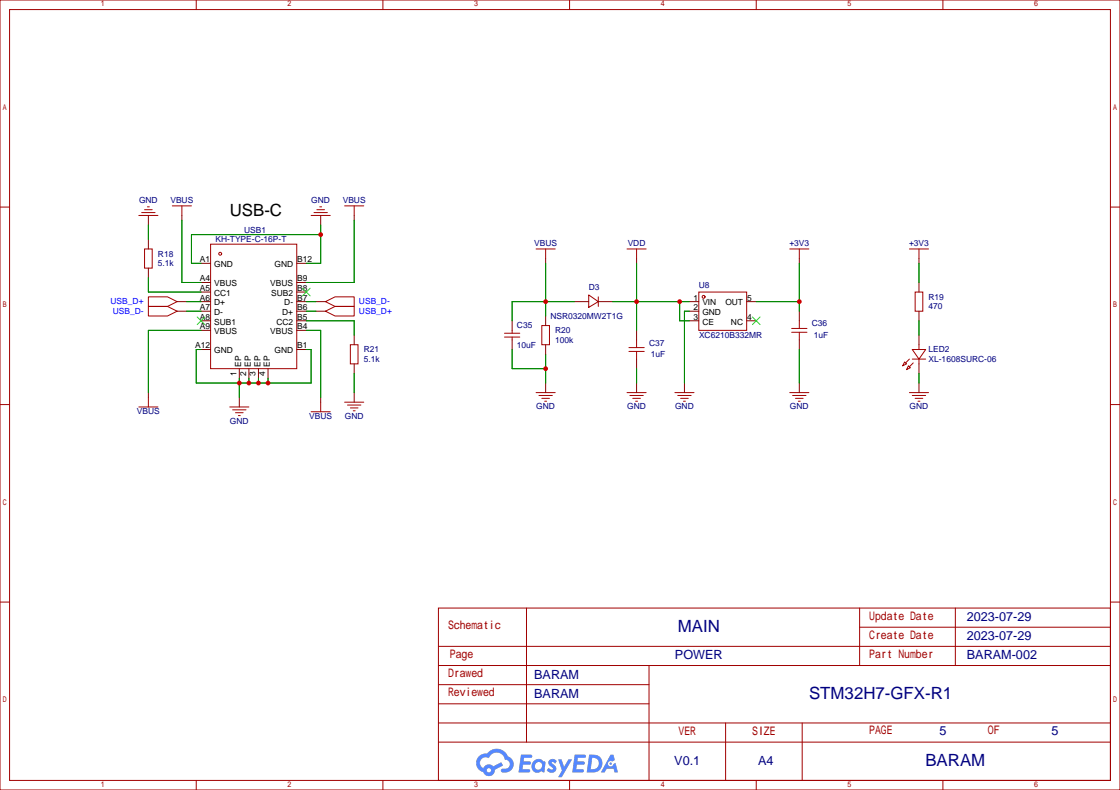
[picture p23: page 5]
