rohamid/h743-lcd-dev/H743_LCD_dev.kicad_pcb

## KiCad design H743_LCD_dev.kicad_pcb (2024-07-26)

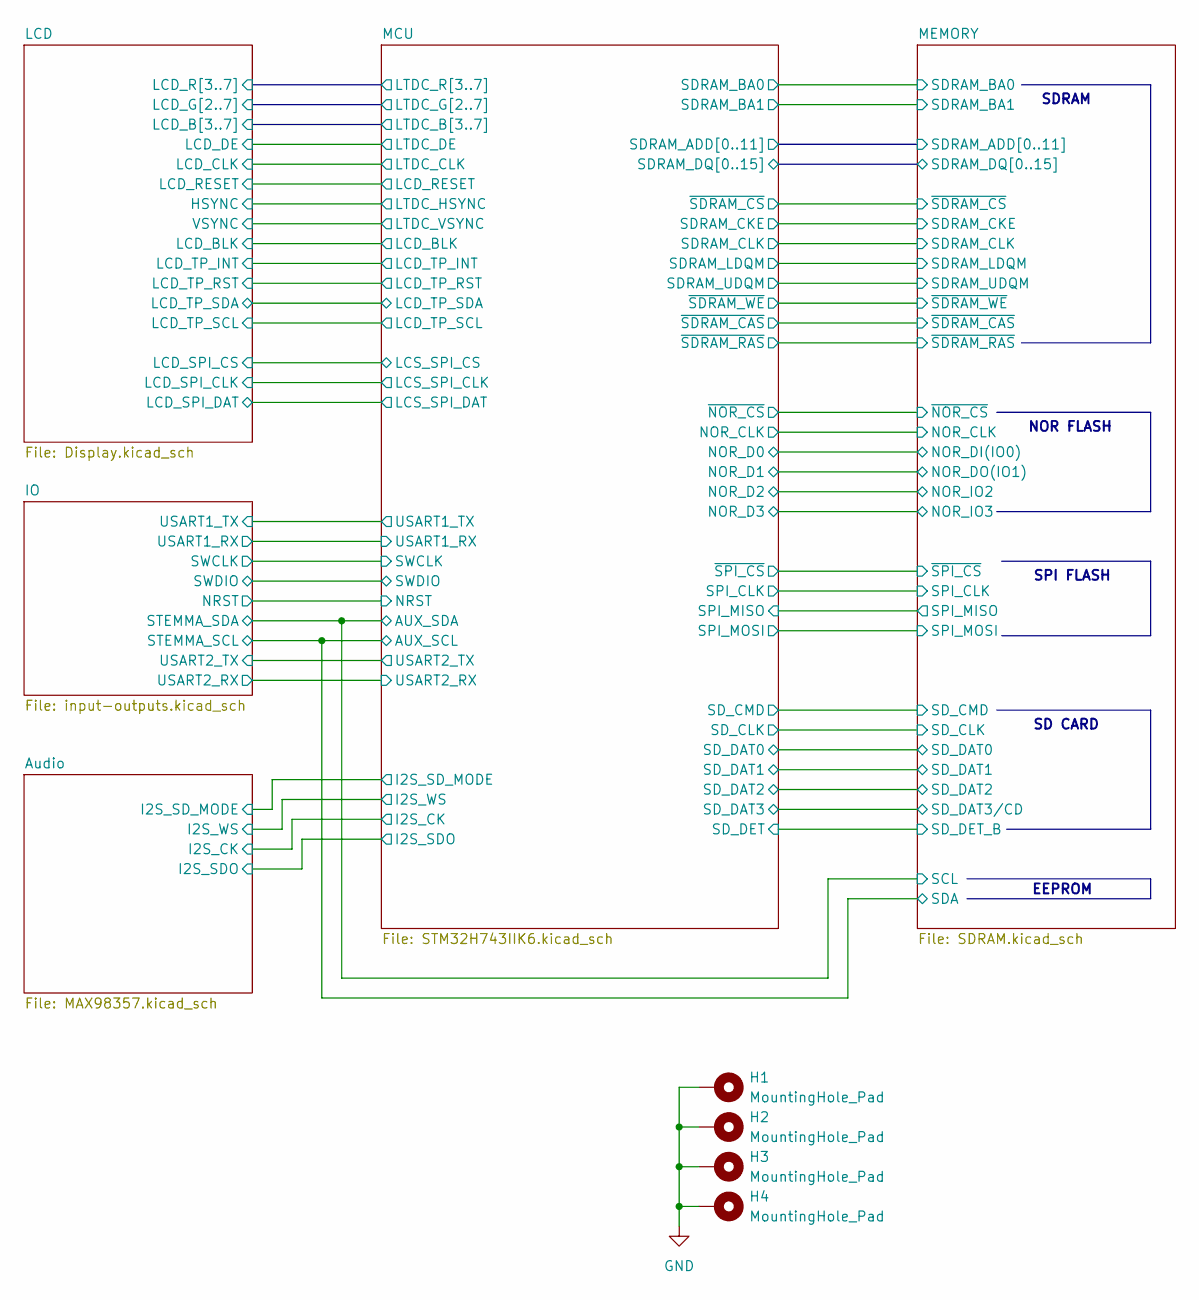
[picture p24: schematic H743_LCD_dev.kicad_sch]

Parts:
H1, H2, H3, H4: MountingHole_Pad; MountingHole_3.2mm_M3_Pad_Via

Connections:
GND: H1.1, H2.1, H3.1, H4.1; also elsewhere on the board

Notes on the sheet:
SD CARD
NOR FLASH
SPI FLASH
SDRAM
EEPROM

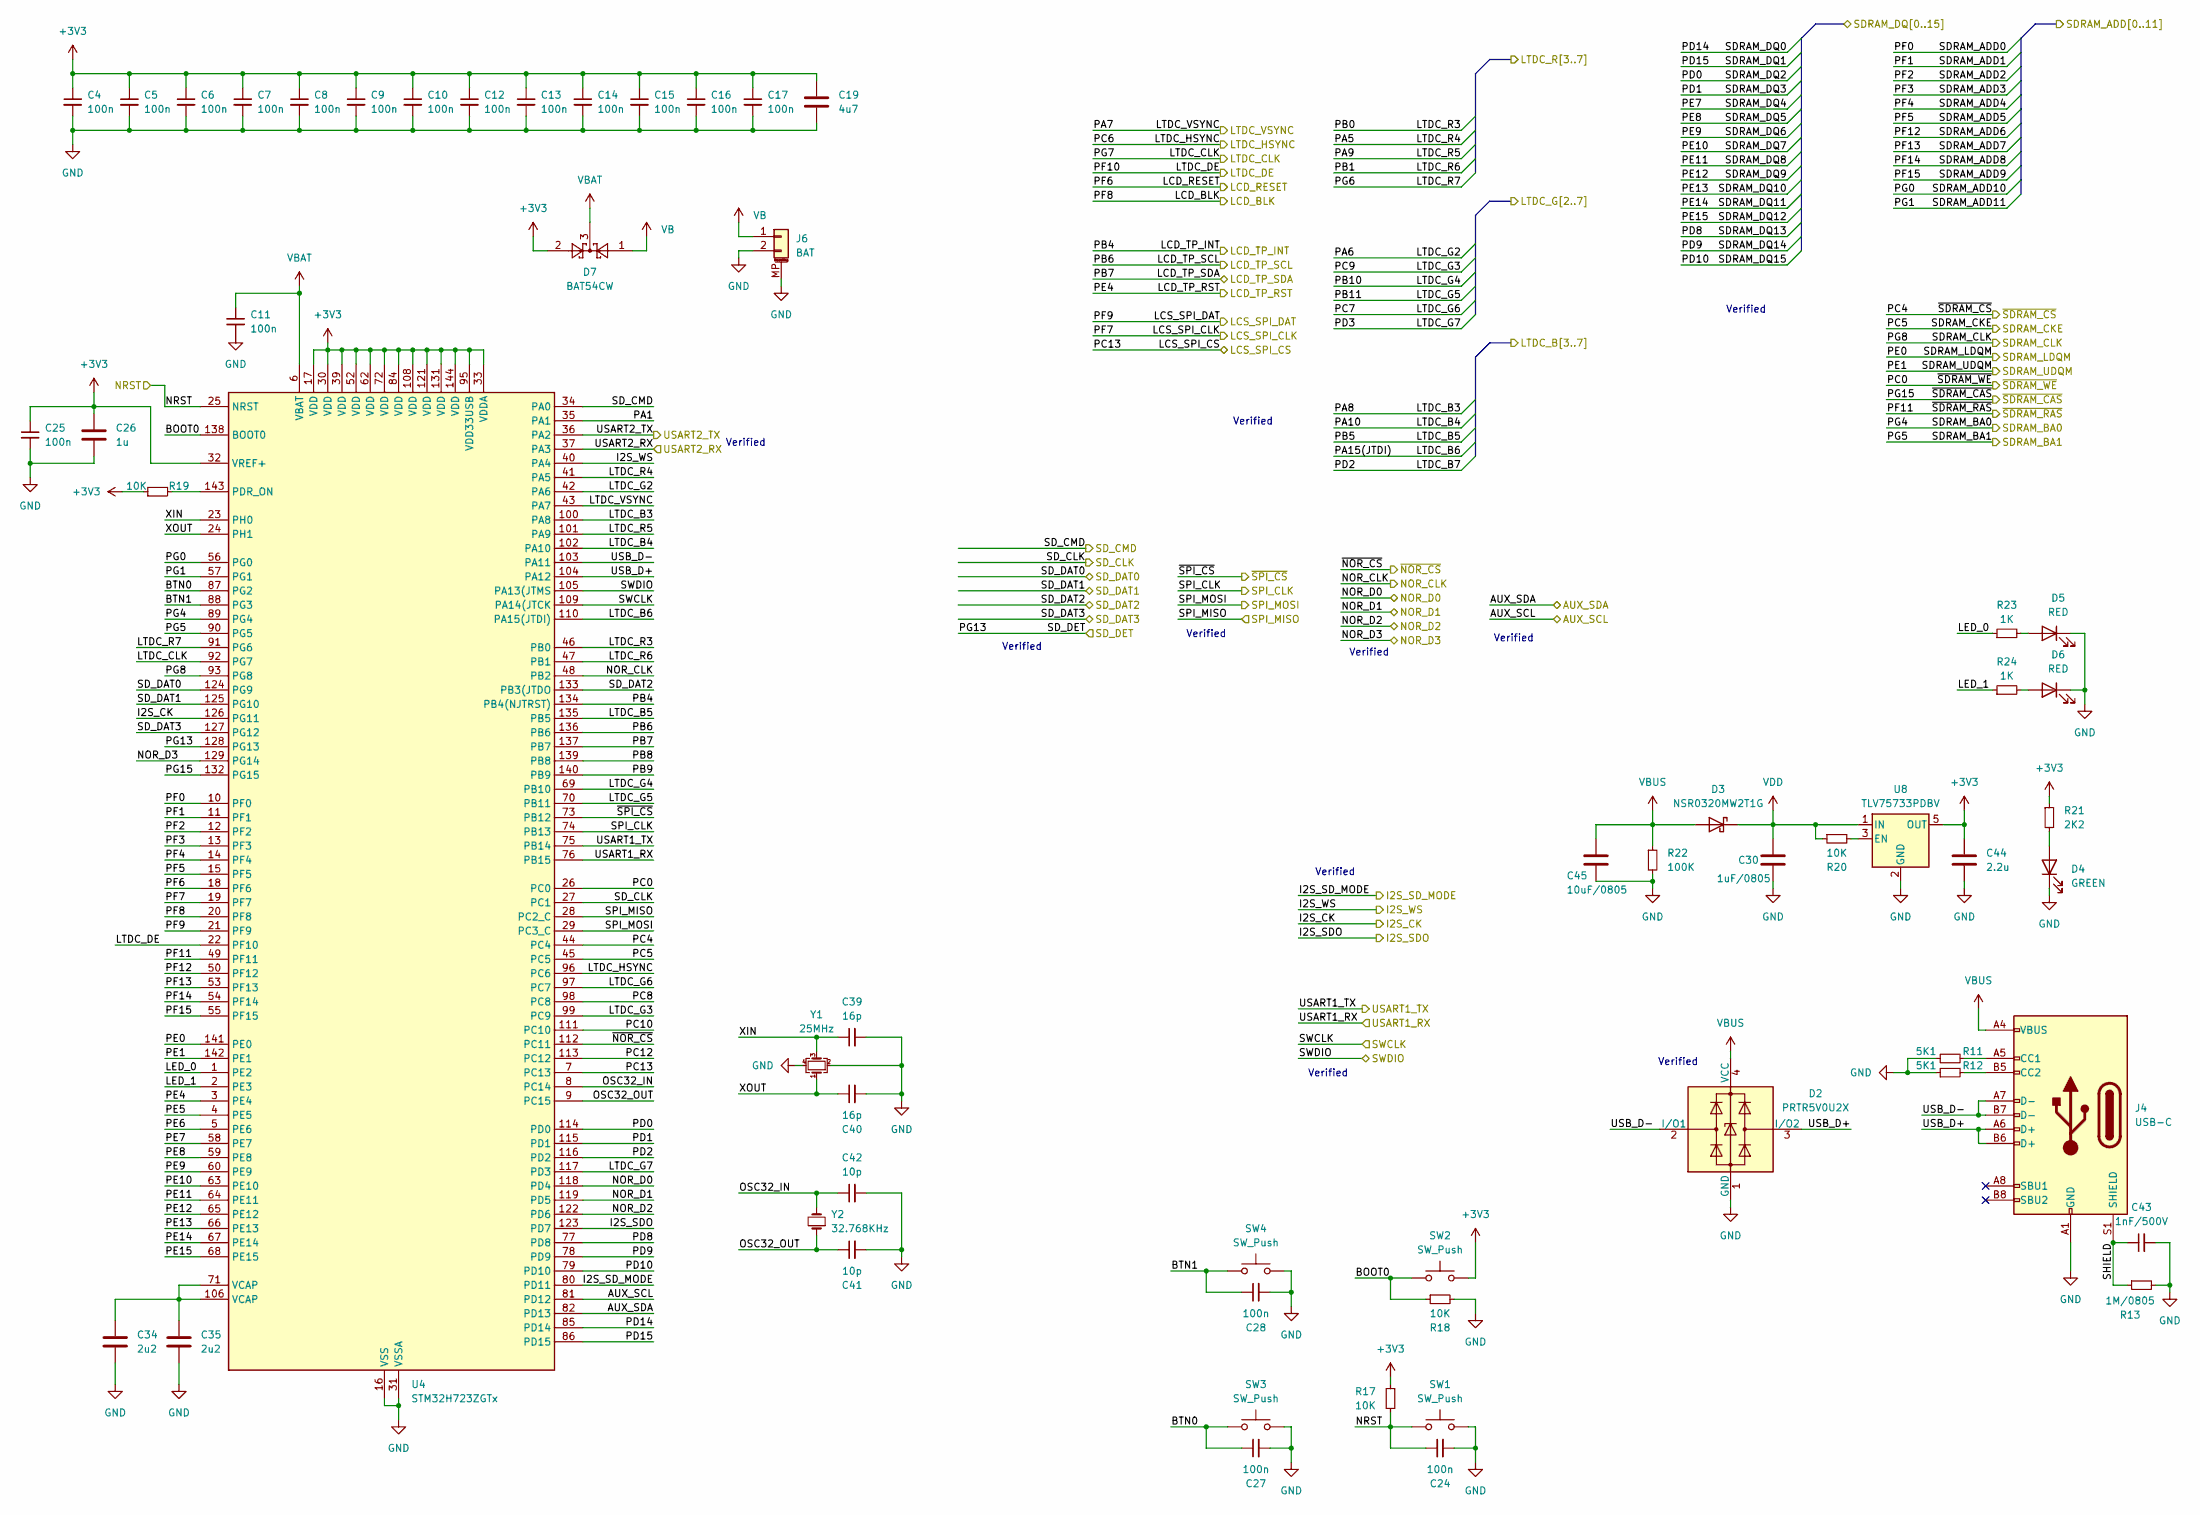
[picture p25: schematic STM32H743IIK6.kicad_sch]

Parts:
C4, C5, C6, C7, C8, C9, C10, C11, C12, C13, C14, C15, C16, C17, C24, C25, C27, C28: 100n; C_0402_1005Metric; JLCPCB Part # C307331
C19: 4u7; C_0603_1608Metric; JLCPCB Part # C19666
C26: 1u; C_0603_1608Metric; JLCPCB Part # C15849
C30: 1uF/0805; C_0805_2012Metric; JLCPCB Part # C28323
C34, C35: 2u2; C_0603_1608Metric; JLCPCB Part # C23630
C39, C40: 16p; C_0402_1005Metric; JLCPCB Part # C77590
C41, C42: 10p; C_0402_1005Metric; JLCPCB Part # C32949
C43: 1nF/500V; C_1206_3216Metric; JLCPCB Part # C35216
C44: 2.2u; C_0805_2012Metric; JLCPCB Part # C377773
C45: 10uF/0805; C_0805_2012Metric; JLCPCB Part # C440198
D2: PRTR5V0U2X; SOT-143; JLCPCB Part # C12333
D3: NSR0320MW2T1G; D_SOD-323; JLCPCB Part # C48192
D4: GREEN; LED_0805_2012Metric; JLCPCB Part # C2297
D5, D6: RED; LED_0805_2012Metric; JLCPCB Part # C84256
D7: BAT54CW; SOT-23; JLCPCB Part # C37704
J4: USB-C; USB_C_Receptacle_G-Switch_GT-USB-7010ASV; JLCPCB Part # C963412
J6: BAT; Hirose_DF13C_CL535-0402-2-51_1x02-1MP_P1.25mm_Vertical; JLCPCB Part # C7419891
R11, R12: 5K1; R_0402_1005Metric; JLCPCB Part # C25905
R13: 1M/0805; R_0805_2012Metric; JLCPCB Part # C17514
R17, R18, R19, R20: 10K; R_0402_1005Metric; JLCPCB Part # C25744
R21: 2K2; R_0402_1005Metric; JLCPCB Part # C25879
R22: 100K; R_0402_1005Metric; JLCPCB Part # C25741
R23, R24: 1K; R_0402_1005Metric; JLCPCB Part # C11702
SW1, SW2, SW3, SW4: SW_Push; SW_SPST_PTS810; JLCPCB Part # C127488
U4: STM32H723ZGTx; LQFP-144_20x20mm_P0.5mm; JLCPCB Part # C730146
U8: TLV75733PDBV; SOT-23-5; JLCPCB Part # C485517
Y1: 25MHz; Crystal_SMD_2520-4Pin_2.5x2.0mm; JLCPCB Part # C255954
Y2: 32.768KHz; Crystal_SMD_2012-2Pin_2.0x1.2mm; JLCPCB Part # C99009

Connections:
+3V3: C4.1, C5.1, C6.1, C7.1, C8.1, C9.1, C10.1, C12.1, C13.1, C14.1, C15.1, C16.1, C17.1, C19.1, C25.1, C26.1, C44.1, D7.2, R17.1, R19.1, R21.1, SW2.2, U4.17 (VDD), U4.30 (VDD), U4.32 (VREF+), U4.33 (VDDA), U4.39 (VDD), U4.52 (VDD), U4.62 (VDD), U4.72 (VDD), U4.84 (VDD), U4.95 (VDD33USB), U4.108 (VDD), U4.121 (VDD), U4.131 (VDD), U4.144 (VDD), U8.5 (OUT); also elsewhere on the board
/IO/NRST: C24.1, R17.2, SW1.1, U4.25 (NRST); also elsewhere on the board
/IO/STEMMA_SCL: U4.81 (PD12); also elsewhere on the board
/IO/STEMMA_SDA: U4.82 (PD13); also elsewhere on the board
/IO/SWCLK: U4.109 (PA14(JTCK); also elsewhere on the board
/IO/SWDIO: U4.105 (PA13(JTMS); also elsewhere on the board
/IO/USART1_RX: U4.76 (PB15); also elsewhere on the board
/IO/USART1_TX: U4.75 (PB14); also elsewhere on the board
/IO/USART2_RX: U4.37 (PA3); also elsewhere on the board
/IO/USART2_TX: U4.36 (PA2); also elsewhere on the board
/LCD/HSYNC: U4.96 (PC6); also elsewhere on the board
/LCD/LCD_B3: U4.100 (PA8); also elsewhere on the board
/LCD/LCD_B4: U4.102 (PA10); also elsewhere on the board
/LCD/LCD_B5: U4.135 (PB5); also elsewhere on the board
/LCD/LCD_B6: U4.110 (PA15(JTDI)); also elsewhere on the board
/LCD/LCD_B7: U4.116 (PD2); also elsewhere on the board
/LCD/LCD_BLK: U4.20 (PF8); also elsewhere on the board
/LCD/LCD_CLK: U4.92 (PG7); also elsewhere on the board
/LCD/LCD_DE: U4.22 (PF10); also elsewhere on the board
/LCD/LCD_G2: U4.42 (PA6); also elsewhere on the board
/LCD/LCD_G3: U4.99 (PC9); also elsewhere on the board
/LCD/LCD_G4: U4.69 (PB10); also elsewhere on the board
/LCD/LCD_G5: U4.70 (PB11); also elsewhere on the board
/LCD/LCD_G6: U4.97 (PC7); also elsewhere on the board
/LCD/LCD_G7: U4.117 (PD3); also elsewhere on the board
/LCD/LCD_R3: U4.46 (PB0); also elsewhere on the board
/LCD/LCD_R4: U4.41 (PA5); also elsewhere on the board
/LCD/LCD_R5: U4.101 (PA9); also elsewhere on the board
/LCD/LCD_R6: U4.47 (PB1); also elsewhere on the board
/LCD/LCD_R7: U4.91 (PG6); also elsewhere on the board
/LCD/LCD_RESET: U4.18 (PF6); also elsewhere on the board
/LCD/LCD_SPI_CLK: U4.19 (PF7); also elsewhere on the board
/LCD/LCD_SPI_CS: U4.7 (PC13); also elsewhere on the board
/LCD/LCD_SPI_DAT: U4.21 (PF9); also elsewhere on the board
/LCD/LCD_TP_INT: U4.134 (PB4(NJTRST)); also elsewhere on the board
/LCD/LCD_TP_RST: U4.3 (PE4); also elsewhere on the board
/LCD/LCD_TP_SCL: U4.136 (PB6); also elsewhere on the board
/LCD/LCD_TP_SDA: U4.137 (PB7); also elsewhere on the board
/LCD/VSYNC: U4.43 (PA7); also elsewhere on the board
/MCU/BOOT0: R18.1, SW2.1, U4.138 (BOOT0)
/MCU/BTN0: C27.1, SW3.1, U4.87 (PG2)
/MCU/BTN1: C28.1, SW4.1, U4.88 (PG3)
/MCU/I2S_CK: U4.126 (PG11); also elsewhere on the board
/MCU/I2S_SDO: U4.123 (PD7); also elsewhere on the board
/MCU/I2S_SD_MODE: U4.80 (PD11); also elsewhere on the board
/MCU/I2S_WS: U4.40 (PA4); also elsewhere on the board
/MCU/LED_0: R23.1, U4.1 (PE2)
/MCU/LED_1: R24.1, U4.2 (PE3)
/MCU/NOR_CLK: U4.48 (PB2); also elsewhere on the board
/MCU/NOR_D0: U4.118 (PD4); also elsewhere on the board
/MCU/NOR_D1: U4.119 (PD5); also elsewhere on the board
/MCU/NOR_D2: U4.122 (PD6); also elsewhere on the board
/MCU/NOR_D3: U4.129 (PG14); also elsewhere on the board
/MCU/OSC32_IN: C42.1, U4.8 (PC14), Y2.2
/MCU/OSC32_OUT: C41.1, U4.9 (PC15), Y2.1
/MCU/PA1: U4.35 (PA1)
/MCU/PB8: U4.139 (PB8)
/MCU/PB9: U4.140 (PB9)
/MCU/PC0: U4.26 (PC0); also elsewhere on the board
/MCU/PC4: U4.44 (PC4); also elsewhere on the board
/MCU/PC5: U4.45 (PC5); also elsewhere on the board
/MCU/PC8: U4.98 (PC8)
/MCU/PC10: U4.111 (PC10)
/MCU/PC12: U4.113 (PC12)
/MCU/PE0: U4.141 (PE0); also elsewhere on the board
/MCU/PE1: U4.142 (PE1); also elsewhere on the board
/MCU/PE5: U4.4 (PE5)
/MCU/PE6: U4.5 (PE6)
/MCU/PF11: U4.49 (PF11); also elsewhere on the board
/MCU/PG4: U4.89 (PG4); also elsewhere on the board
/MCU/PG5: U4.90 (PG5); also elsewhere on the board
/MCU/PG8: U4.93 (PG8); also elsewhere on the board
/MCU/PG13: U4.128 (PG13); also elsewhere on the board
/MCU/PG15: U4.132 (PG15); also elsewhere on the board
/MCU/SDRAM_ADD0: U4.10 (PF0); also elsewhere on the board
/MCU/SDRAM_ADD1: U4.11 (PF1); also elsewhere on the board
/MCU/SDRAM_ADD2: U4.12 (PF2); also elsewhere on the board
/MCU/SDRAM_ADD3: U4.13 (PF3); also elsewhere on the board
/MCU/SDRAM_ADD4: U4.14 (PF4); also elsewhere on the board
/MCU/SDRAM_ADD5: U4.15 (PF5); also elsewhere on the board
/MCU/SDRAM_ADD6: U4.50 (PF12); also elsewhere on the board
/MCU/SDRAM_ADD7: U4.53 (PF13); also elsewhere on the board
/MCU/SDRAM_ADD8: U4.54 (PF14); also elsewhere on the board
/MCU/SDRAM_ADD9: U4.55 (PF15); also elsewhere on the board
/MCU/SDRAM_ADD10: U4.56 (PG0); also elsewhere on the board
/MCU/SDRAM_ADD11: U4.57 (PG1); also elsewhere on the board
/MCU/SDRAM_DQ0: U4.85 (PD14); also elsewhere on the board
/MCU/SDRAM_DQ1: U4.86 (PD15); also elsewhere on the board
/MCU/SDRAM_DQ2: U4.114 (PD0); also elsewhere on the board
/MCU/SDRAM_DQ3: U4.115 (PD1); also elsewhere on the board
/MCU/SDRAM_DQ4: U4.58 (PE7); also elsewhere on the board
/MCU/SDRAM_DQ5: U4.59 (PE8); also elsewhere on the board
/MCU/SDRAM_DQ6: U4.60 (PE9); also elsewhere on the board
/MCU/SDRAM_DQ7: U4.63 (PE10); also elsewhere on the board
/MCU/SDRAM_DQ8: U4.64 (PE11); also elsewhere on the board
/MCU/SDRAM_DQ9: U4.65 (PE12); also elsewhere on the board
/MCU/SDRAM_DQ10: U4.66 (PE13); also elsewhere on the board
/MCU/SDRAM_DQ11: U4.67 (PE14); also elsewhere on the board
/MCU/SDRAM_DQ12: U4.68 (PE15); also elsewhere on the board
/MCU/SDRAM_DQ13: U4.77 (PD8); also elsewhere on the board
/MCU/SDRAM_DQ14: U4.78 (PD9); also elsewhere on the board
/MCU/SDRAM_DQ15: U4.79 (PD10); also elsewhere on the board
/MCU/SD_CLK: U4.27 (PC1); also elsewhere on the board
/MCU/SD_CMD: U4.34 (PA0); also elsewhere on the board
/MCU/SD_DAT0: U4.124 (PG9); also elsewhere on the board
/MCU/SD_DAT1: U4.125 (PG10); also elsewhere on the board
/MCU/SD_DAT2: U4.133 (PB3(JTDO); also elsewhere on the board
/MCU/SD_DAT3: U4.127 (PG12); also elsewhere on the board
/MCU/SHIELD: C43.1, J4.S1 (SHIELD), R13.1
/MCU/SPI_CLK: U4.74 (PB13); also elsewhere on the board
/MCU/SPI_MISO: U4.28 (PC2_C); also elsewhere on the board
/MCU/SPI_MOSI: U4.29 (PC3_C); also elsewhere on the board
/MCU/USB_D+: D2.3 (I/O2), J4.A6 (D+), J4.B6 (D+), U4.104 (PA12)
/MCU/USB_D-: D2.2 (I/O1), J4.A7 (D-), J4.B7 (D-), U4.103 (PA11)
/MCU/XIN: C39.1, U4.23 (PH0), Y1.3
/MCU/XOUT: C40.1, U4.24 (PH1), Y1.1
/MCU/~NOR_CS: U4.112 (PC11); also elsewhere on the board
/MCU/~SPI_CS: U4.73 (PB12); also elsewhere on the board
GND: C4.2, C5.2, C6.2, C7.2, C8.2, C9.2, C10.2, C11.2, C12.2, C13.2, C14.2, C15.2, C16.2, C17.2, C19.2, C24.2, C25.2, C26.2, C27.2, C28.2, C30.2, C34.2, C35.2, C39.2, C40.2, C41.2, C42.2, C43.2, C44.2, C45.2, D2.1 (GND), D4.1 (K), D5.1 (K), D6.1 (K), J4.A1 (GND), J4.A12 (GND), J4.B1 (GND), J4.B12 (GND), J6.2, J6.MP (MountPin), R11.1, R12.1, R13.2, R18.2, R22.2, SW1.2, SW3.2, SW4.2, U4.16 (VSS), U4.31 (VSSA), U4.38 (VSS), U4.51 (VSS), U4.61 (VSS), U4.83 (VSS), U4.94 (VSS), U4.107 (VSS), U4.120 (VSS), U4.130 (VSS), U8.2 (GND), Y1.2, Y1.4; also elsewhere on the board
unnamed: C34.1, C35.1, U4.71 (VCAP), U4.106 (VCAP)
unnamed: D4.2 (A), R21.2
unnamed: D5.2 (A), R23.2
unnamed: D6.2 (A), R24.2
unnamed: J4.A5 (CC1), R11.2
unnamed: J4.B5 (CC2), R12.2
unnamed: R19.2, U4.143 (PDR_ON)
unnamed: R20.2, U8.3 (EN)
VB: D7.1, J6.1
VBAT: C11.1, D7.3, U4.6 (VBAT)
VBUS: C45.1, D2.4 (VCC), D3.2 (A), J4.A4 (VBUS), J4.A9 (VBUS), J4.B4 (VBUS), J4.B9 (VBUS), R22.1
VDD: C30.1, D3.1 (K), R20.1, U8.1 (IN); also elsewhere on the board

Notes on the sheet:
Verified

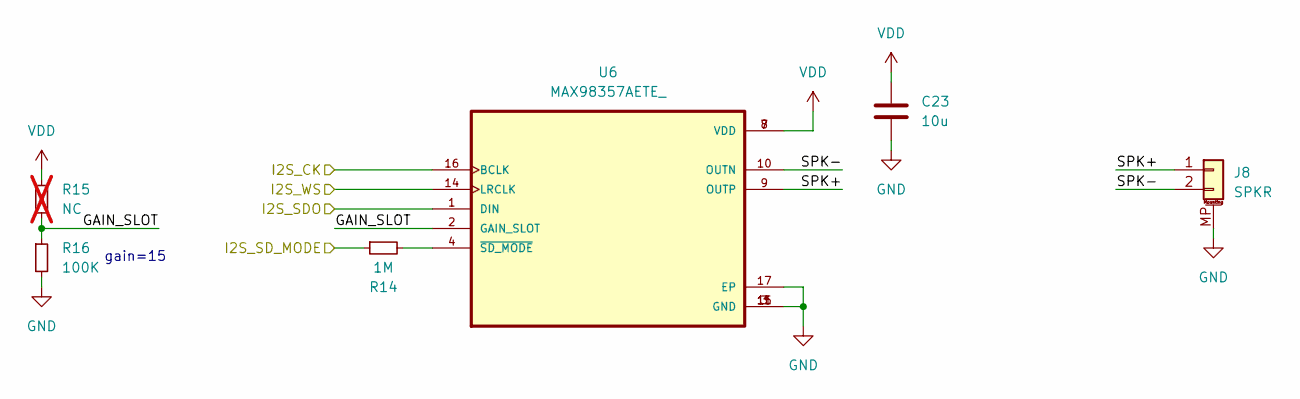
[picture p26: schematic MAX98357.kicad_sch]

Parts:
C23: 10u; C_0603_1608Metric; JLCPCB Part # C96446
J8: SPKR; Hirose_DF13C_CL535-0402-2-51_1x02-1MP_P1.25mm_Vertical; JLCPCB Part # C7419891
R14: 1M; R_0402_1005Metric; JLCPCB Part # C26083
R15: NC; R_0402_1005Metric; not fitted
R16: 100K; R_0402_1005Metric; JLCPCB Part # C25741
U6: MAX98357AETE_; QFN50P300X300X80-17N; JLCPCB Part # C910544

Connections:
/Audio/GAIN_SLOT: R15.2, R16.1, U6.2 (GAIN_SLOT)
/Audio/SPK+: J8.1, U6.9 (OUTP)
/Audio/SPK-: J8.2, U6.10 (OUTN)
/MCU/I2S_CK: U6.16 (BCLK); also elsewhere on the board
/MCU/I2S_SDO: U6.1 (DIN); also elsewhere on the board
/MCU/I2S_SD_MODE: R14.1; also elsewhere on the board
/MCU/I2S_WS: U6.14 (LRCLK); also elsewhere on the board
GND: C23.2, J8.MP (MountPin), R16.2, U6.3 (GND), U6.11 (GND), U6.15 (GND), U6.17 (EP); also elsewhere on the board
unnamed: R14.2, U6.4 (~SD_MODE)
VDD: C23.1, R15.1, U6.7 (VDD), U6.8 (VDD); also elsewhere on the board

Notes on the sheet:
gain=15

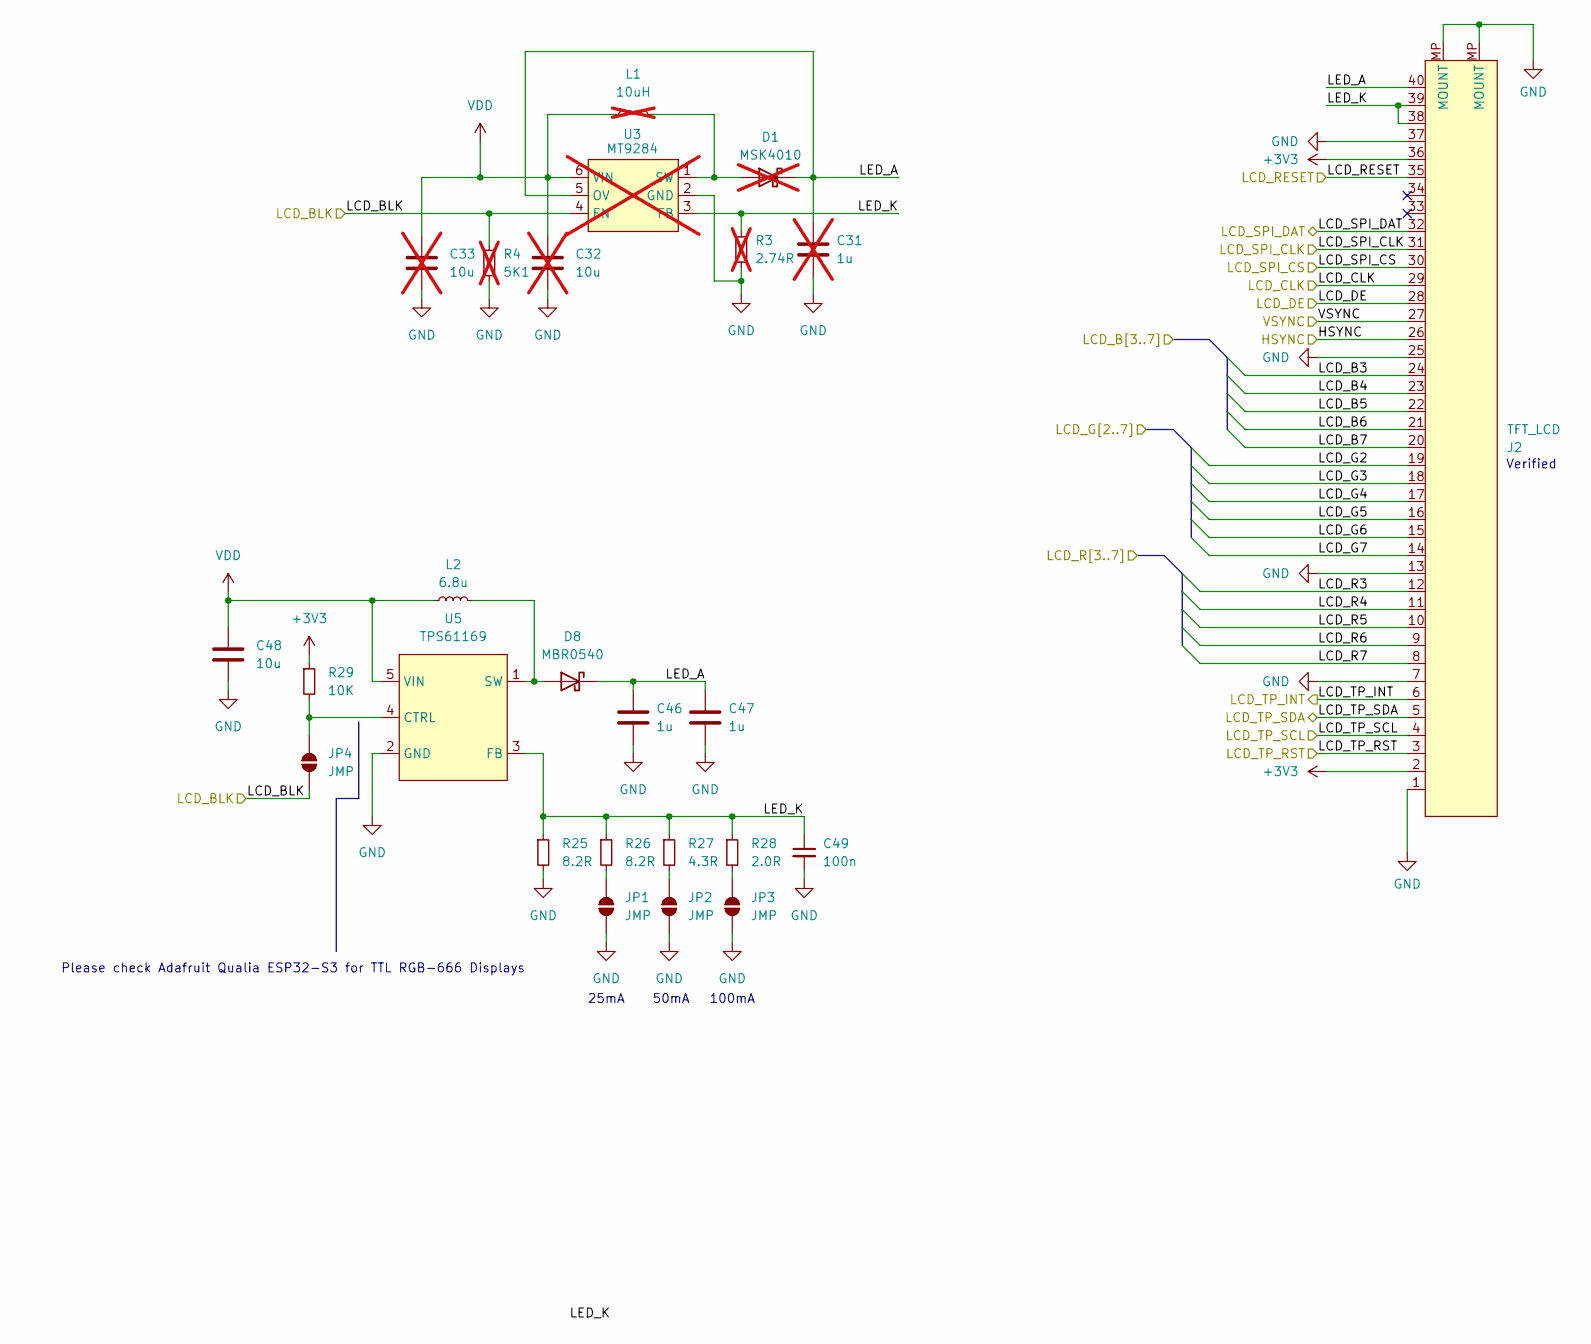
[picture p27: schematic Display.kicad_sch]

Parts:
C31: 1u; C_0603_1608Metric; JLCPCB Part # C15849; not fitted
C32, C33: 10u; C_0603_1608Metric; JLCPCB Part # C96446; not fitted
C46, C47: 1u; C_0603_1608Metric; JLCPCB Part # C15849
C48: 10u; C_0603_1608Metric; JLCPCB Part # C96446
C49: 100n; C_0402_1005Metric; JLCPCB Part # C307331
D1: MSK4010; D_SOD-523; JLCPCB Part # C345958; not fitted
D8: MBR0540; D_SOD-123; JLCPCB Part # C21353
J2: TFT_LCD; Omron-XF2M-4015-1A-R100-0-0-0; JLCPCB Part # C225713
JP1, JP2, JP3, JP4: JMP; SolderJumper-2_P1.3mm_Open_RoundedPad1.0x1.5mm
L1: 10uH; L_1210_3225Metric; JLCPCB Part # C189932; not fitted
L2: 6.8u; L_Changjiang_FNR5012S; JLCPCB Part # C2847472
R3: 2.74R; R_0402_1005Metric; JLCPCB Part # C166483; not fitted
R4: 5K1; R_0402_1005Metric; JLCPCB Part # C25905; not fitted
R25, R26: 8.2R; R_0402_1005Metric; JLCPCB Part # C514788
R27: 4.3R; R_0402_1005Metric; JLCPCB Part # C166641
R28: 2.0R; R_0402_1005Metric; JLCPCB Part # C203084
R29: 10K; R_0402_1005Metric; JLCPCB Part # C25744
U3: MT9284; SOT-23-6; JLCPCB Part # C181780; not fitted
U5: TPS61169; SOT-353_SC-70-5; JLCPCB Part # C71045

Connections:
+3V3: J2.2, J2.36, R29.1; also elsewhere on the board
/LCD/HSYNC: J2.26; also elsewhere on the board
/LCD/LCD_B3: J2.24; also elsewhere on the board
/LCD/LCD_B4: J2.23; also elsewhere on the board
/LCD/LCD_B5: J2.22; also elsewhere on the board
/LCD/LCD_B6: J2.21; also elsewhere on the board
/LCD/LCD_B7: J2.20; also elsewhere on the board
/LCD/LCD_BLK: JP4.1 (A), R4.1, U3.4 (EN); also elsewhere on the board
/LCD/LCD_CLK: J2.29; also elsewhere on the board
/LCD/LCD_DE: J2.28; also elsewhere on the board
/LCD/LCD_G2: J2.19; also elsewhere on the board
/LCD/LCD_G3: J2.18; also elsewhere on the board
/LCD/LCD_G4: J2.17; also elsewhere on the board
/LCD/LCD_G5: J2.16; also elsewhere on the board
/LCD/LCD_G6: J2.15; also elsewhere on the board
/LCD/LCD_G7: J2.14; also elsewhere on the board
/LCD/LCD_R3: J2.12; also elsewhere on the board
/LCD/LCD_R4: J2.11; also elsewhere on the board
/LCD/LCD_R5: J2.10; also elsewhere on the board
/LCD/LCD_R6: J2.9; also elsewhere on the board
/LCD/LCD_R7: J2.8; also elsewhere on the board
/LCD/LCD_RESET: J2.35; also elsewhere on the board
/LCD/LCD_SPI_CLK: J2.31; also elsewhere on the board
/LCD/LCD_SPI_CS: J2.30; also elsewhere on the board
/LCD/LCD_SPI_DAT: J2.32; also elsewhere on the board
/LCD/LCD_TP_INT: J2.6; also elsewhere on the board
/LCD/LCD_TP_RST: J2.3; also elsewhere on the board
/LCD/LCD_TP_SCL: J2.4; also elsewhere on the board
/LCD/LCD_TP_SDA: J2.5; also elsewhere on the board
/LCD/LED_A: C31.1, C46.1, C47.1, D1.1 (K), D8.1 (K), J2.40, U3.5 (OV)
/LCD/LED_K: C49.1, J2.38, J2.39, R3.1, R25.1, R26.1, R27.1, R28.1, U3.3 (FB), U5.3 (FB)
/LCD/VSYNC: J2.27; also elsewhere on the board
GND: C31.2, C32.2, C33.2, C46.2, C47.2, C48.2, C49.2, J2.1, J2.7, J2.13, J2.25, J2.37, J2.MP (MOUNT), JP1.1 (A), JP2.1 (A), JP3.1 (A), R3.2, R4.2, R25.2, U3.2 (GND), U5.2 (GND); also elsewhere on the board
unnamed: D1.2 (A), L1.2, U3.1 (SW)
unnamed: D8.2 (A), L2.2, U5.1 (SW)
unnamed: JP1.2 (B), R26.2
unnamed: JP2.2 (B), R27.2
unnamed: JP3.2 (B), R28.2
unnamed: JP4.2 (B), R29.2, U5.4 (CTRL)
VDD: C32.1, C33.1, C48.1, L1.1, L2.1, U3.6 (VIN), U5.5 (VIN); also elsewhere on the board

Notes on the sheet:
100mA
50mA
25mA
Verified
Please check Adafruit Qualia ESP32-S3 for TTL RGB-666 Displays

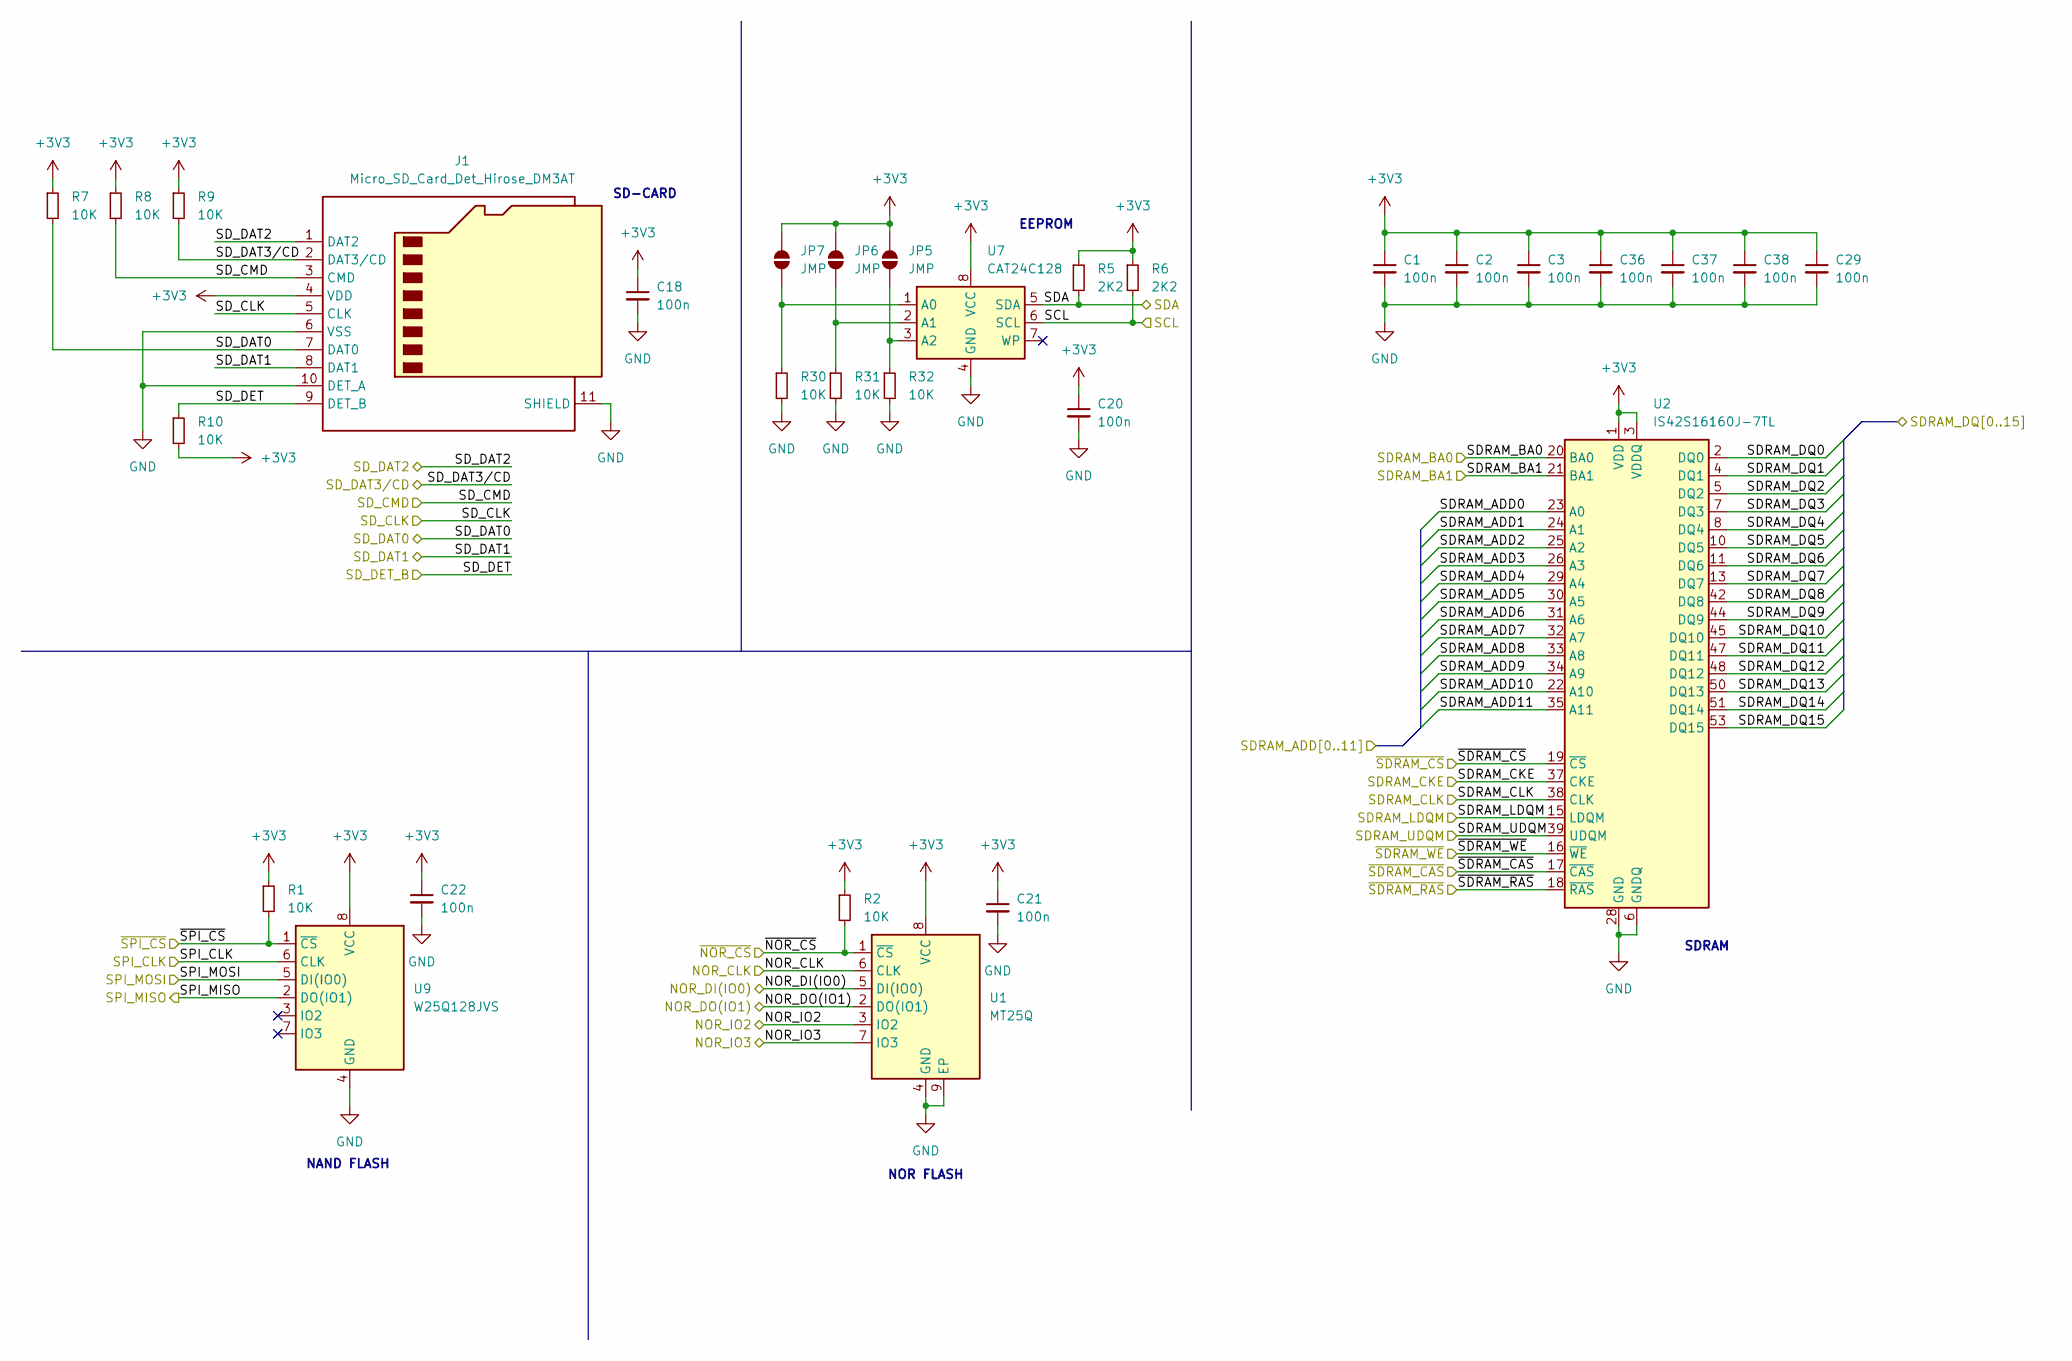
[picture p28: schematic SDRAM.kicad_sch]

Parts:
C1, C2, C3, C18, C20, C21, C22, C29, C36, C37, C38: 100n; C_0402_1005Metric; JLCPCB Part # C307331
J1: Micro_SD_Card_Det_Hirose_DM3AT; microSD_HC_Hirose_DM3AT-SF-PEJM5; JLCPCB Part # C114218
JP5, JP6, JP7: JMP; SolderJumper-2_P1.3mm_Open_RoundedPad1.0x1.5mm
R1, R2, R7, R8, R9, R10, R30, R31, R32: 10K; R_0402_1005Metric; JLCPCB Part # C25744
R5, R6: 2K2; R_0402_1005Metric; JLCPCB Part # C25879
U1: MT25Q; WSON-8-1EP_8x6mm_P1.27mm_EP3.4x4.3mm; JLCPCB Part # C2061007
U2: IS42S16160J-7TL; TSOP-II-54_22.2x10.16mm_P0.8mm; JLCPCB Part # C412833
U7: CAT24C128; SOIC-8_3.9x4.9mm_P1.27mm; JLCPCB Part # C6482
U9: W25Q128JVS; SOIC-8_5.23x5.23mm_P1.27mm; JLCPCB Part # C97521

Connections:
+3V3: C1.1, C2.1, C3.1, C18.1, C20.1, C21.1, C22.1, C29.1, C36.1, C37.1, C38.1, J1.4 (VDD), JP5.2 (B), JP6.2 (B), JP7.2 (B), R1.1, R2.1, R5.1, R6.1, R7.1, R8.1, R9.1, R10.2, U1.8 (VCC), U2.1 (VDD), U2.3 (VDDQ), U2.9 (VDDQ), U2.14 (VDD), U2.27 (VDD), U2.43 (VDDQ), U2.49 (VDDQ), U7.8 (VCC), U9.8 (VCC); also elsewhere on the board
/IO/STEMMA_SCL: R5.2, U7.5 (SDA); also elsewhere on the board
/IO/STEMMA_SDA: R6.2, U7.6 (SCL); also elsewhere on the board
/MCU/NOR_CLK: U1.6 (CLK); also elsewhere on the board
/MCU/NOR_D0: U1.5 (DI(IO0)); also elsewhere on the board
/MCU/NOR_D1: U1.2 (DO(IO1)); also elsewhere on the board
/MCU/NOR_D2: U1.3 (IO2); also elsewhere on the board
/MCU/NOR_D3: U1.7 (IO3); also elsewhere on the board
/MCU/PC0: U2.16 (~WE); also elsewhere on the board
/MCU/PC4: U2.19 (~CS); also elsewhere on the board
/MCU/PC5: U2.37 (CKE); also elsewhere on the board
/MCU/PE0: U2.15 (LDQM); also elsewhere on the board
/MCU/PE1: U2.39 (UDQM); also elsewhere on the board
/MCU/PF11: U2.18 (~RAS); also elsewhere on the board
/MCU/PG4: U2.20 (BA0); also elsewhere on the board
/MCU/PG5: U2.21 (BA1); also elsewhere on the board
/MCU/PG8: U2.38 (CLK); also elsewhere on the board
/MCU/PG13: J1.9 (DET_B), R10.1; also elsewhere on the board
/MCU/PG15: U2.17 (~CAS); also elsewhere on the board
/MCU/SDRAM_ADD0: U2.23 (A0); also elsewhere on the board
/MCU/SDRAM_ADD1: U2.24 (A1); also elsewhere on the board
/MCU/SDRAM_ADD2: U2.25 (A2); also elsewhere on the board
/MCU/SDRAM_ADD3: U2.26 (A3); also elsewhere on the board
/MCU/SDRAM_ADD4: U2.29 (A4); also elsewhere on the board
/MCU/SDRAM_ADD5: U2.30 (A5); also elsewhere on the board
/MCU/SDRAM_ADD6: U2.31 (A6); also elsewhere on the board
/MCU/SDRAM_ADD7: U2.32 (A7); also elsewhere on the board
/MCU/SDRAM_ADD8: U2.33 (A8); also elsewhere on the board
/MCU/SDRAM_ADD9: U2.34 (A9); also elsewhere on the board
/MCU/SDRAM_ADD10: U2.22 (A10); also elsewhere on the board
/MCU/SDRAM_ADD11: U2.35 (A11); also elsewhere on the board
/MCU/SDRAM_DQ0: U2.2 (DQ0); also elsewhere on the board
/MCU/SDRAM_DQ1: U2.4 (DQ1); also elsewhere on the board
/MCU/SDRAM_DQ2: U2.5 (DQ2); also elsewhere on the board
/MCU/SDRAM_DQ3: U2.7 (DQ3); also elsewhere on the board
/MCU/SDRAM_DQ4: U2.8 (DQ4); also elsewhere on the board
/MCU/SDRAM_DQ5: U2.10 (DQ5); also elsewhere on the board
/MCU/SDRAM_DQ6: U2.11 (DQ6); also elsewhere on the board
/MCU/SDRAM_DQ7: U2.13 (DQ7); also elsewhere on the board
/MCU/SDRAM_DQ8: U2.42 (DQ8); also elsewhere on the board
/MCU/SDRAM_DQ9: U2.44 (DQ9); also elsewhere on the board
/MCU/SDRAM_DQ10: U2.45 (DQ10); also elsewhere on the board
/MCU/SDRAM_DQ11: U2.47 (DQ11); also elsewhere on the board
/MCU/SDRAM_DQ12: U2.48 (DQ12); also elsewhere on the board
/MCU/SDRAM_DQ13: U2.50 (DQ13); also elsewhere on the board
/MCU/SDRAM_DQ14: U2.51 (DQ14); also elsewhere on the board
/MCU/SDRAM_DQ15: U2.53 (DQ15); also elsewhere on the board
/MCU/SD_CLK: J1.5 (CLK); also elsewhere on the board
/MCU/SD_CMD: J1.3 (CMD), R8.2; also elsewhere on the board
/MCU/SD_DAT0: J1.7 (DAT0), R7.2; also elsewhere on the board
/MCU/SD_DAT1: J1.8 (DAT1); also elsewhere on the board
/MCU/SD_DAT2: J1.1 (DAT2); also elsewhere on the board
/MCU/SD_DAT3: J1.2 (DAT3/CD), R9.2; also elsewhere on the board
/MCU/SPI_CLK: U9.6 (CLK); also elsewhere on the board
/MCU/SPI_MISO: U9.2 (DO(IO1)); also elsewhere on the board
/MCU/SPI_MOSI: U9.5 (DI(IO0)); also elsewhere on the board
/MCU/~NOR_CS: R2.2, U1.1 (~CS); also elsewhere on the board
/MCU/~SPI_CS: R1.2, U9.1 (~CS); also elsewhere on the board
GND: C1.2, C2.2, C3.2, C18.2, C20.2, C21.2, C22.2, C29.2, C36.2, C37.2, C38.2, J1.6 (VSS), J1.10 (DET_A), J1.11 (SHIELD), R30.2, R31.2, R32.2, U1.4 (GND), U1.9 (EP), U2.6 (GNDQ), U2.12 (GNDQ), U2.28 (GND), U2.41 (GND), U2.46 (GNDQ), U2.52 (GNDQ), U2.54 (GND), U7.4 (GND), U9.4 (GND); also elsewhere on the board
unnamed: JP5.1 (A), R32.1, U7.3 (A2)
unnamed: JP6.1 (A), R31.1, U7.2 (A1)
unnamed: JP7.1 (A), R30.1, U7.1 (A0)

Notes on the sheet:
NOR FLASH
SD-CARD
SDRAM
EEPROM
NAND FLASH
