rohamid/h743-lcd-dev/H743_LCD_dev.kicad_pcb

## KiCad design H743_LCD_dev.kicad_pcb (continued)

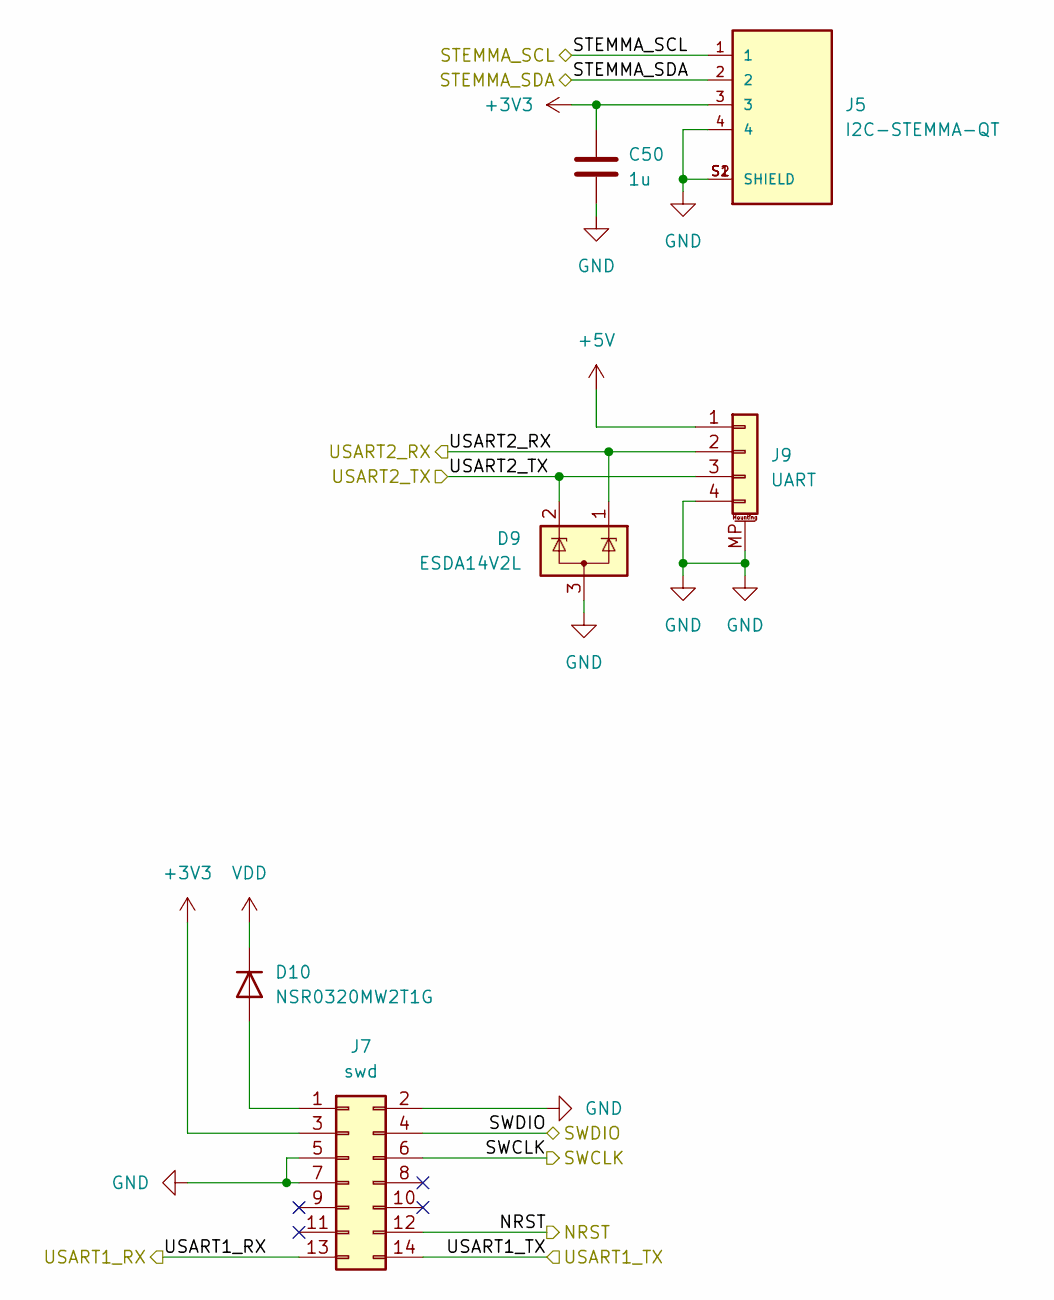
[picture p29: schematic input-outputs.kicad_sch]

Parts:
C50: 1u; C_0603_1608Metric; JLCPCB Part # C15849
D9: ESDA14V2L; SOT-23; JLCPCB Part # C2682282
D10: NSR0320MW2T1G; D_SOD-323; JLCPCB Part # C48192
J5: I2C-STEMMA-QT; JST_SM04B-SRSS-TB_LF__SN_; JLCPCB Part # C160404
J7: swd; PinHeader_2x07_P1.27mm_Vertical_SMD; JLCPCB Part # C2881912
J9: UART; S4BXHSM4TBLFSN; JLCPCB Part # C146120

Connections:
+3V3: C50.1, J5.3, J7.3; also elsewhere on the board
+5V: J9.1
/IO/NRST: J7.12; also elsewhere on the board
/IO/STEMMA_SCL: J5.1; also elsewhere on the board
/IO/STEMMA_SDA: J5.2; also elsewhere on the board
/IO/SWCLK: J7.6; also elsewhere on the board
/IO/SWDIO: J7.4; also elsewhere on the board
/IO/USART1_RX: J7.13; also elsewhere on the board
/IO/USART1_TX: J7.14; also elsewhere on the board
/IO/USART2_RX: D9.1 (K), J9.2; also elsewhere on the board
/IO/USART2_TX: D9.2 (K), J9.3; also elsewhere on the board
GND: C50.2, D9.3 (A), J5.4, J5.S1 (SHIELD), J5.S2 (SHIELD), J7.2, J7.5, J7.7, J9.4, J9.MP (MountPin); also elsewhere on the board
unnamed: D10.2 (A), J7.1
VDD: D10.1 (K); also elsewhere on the board

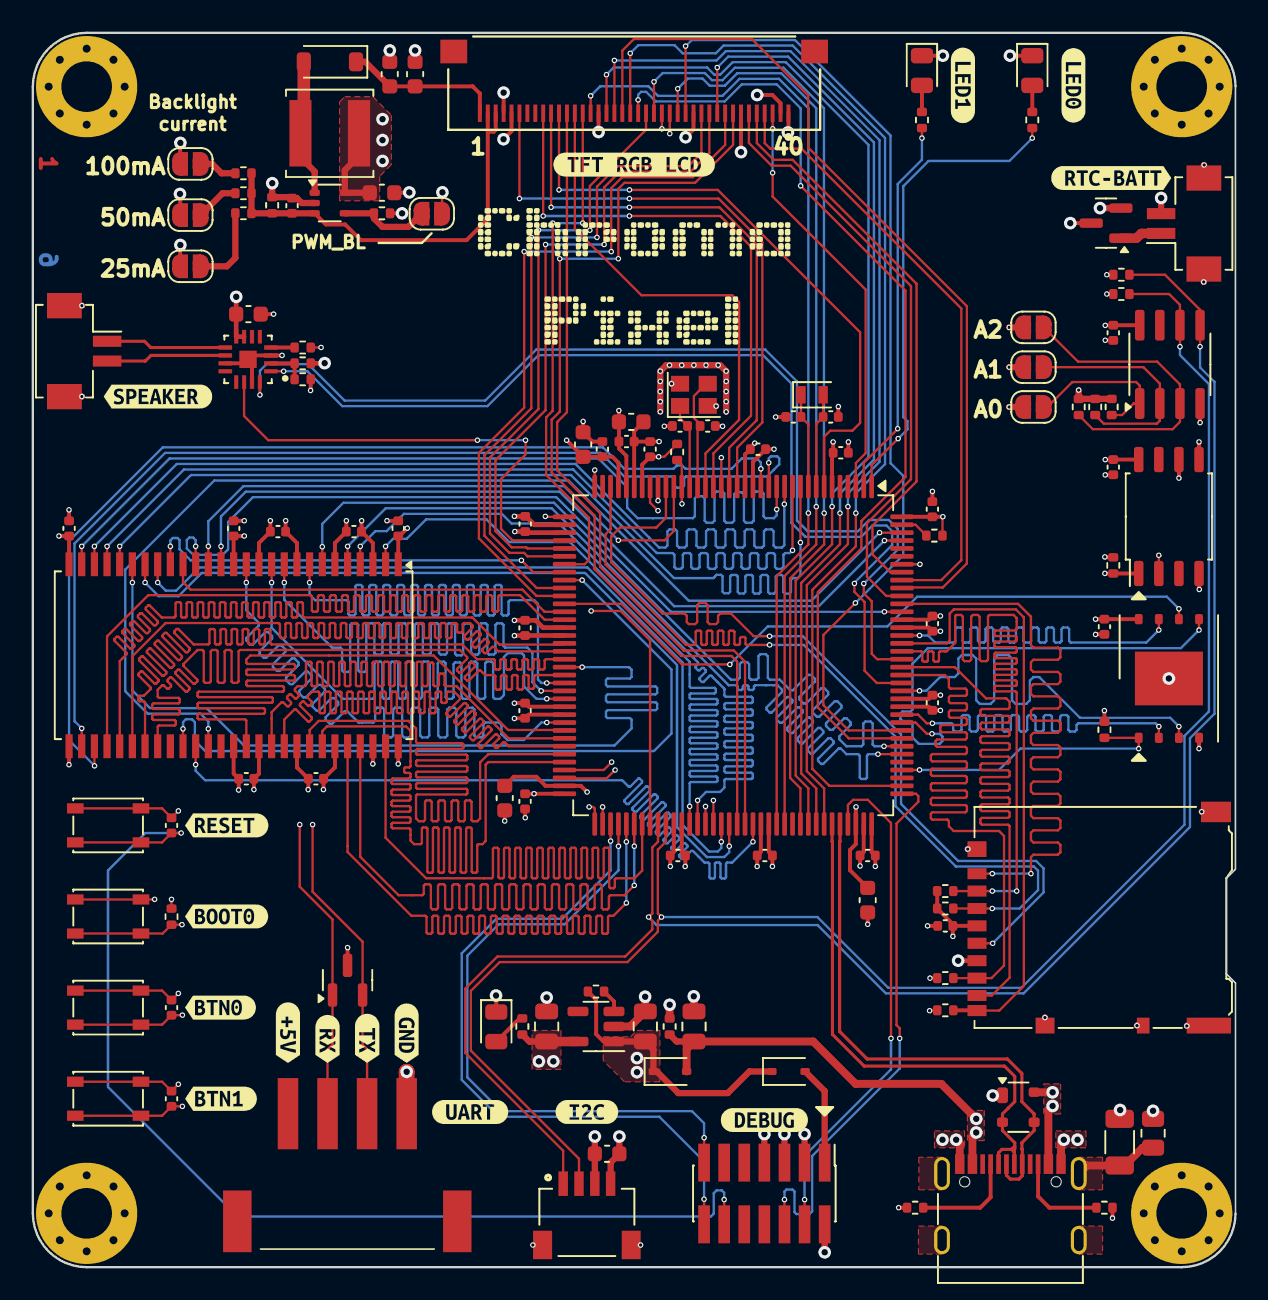
[picture p30: board H743_LCD_dev.kicad_pcb from above]

Board: 6 copper layers, 76.0 x 78.0 mm, 136 parts (0 on the bottom side), 138 nets.

Other parts of the board:
kibuzzard-6641D1A5: G***; kibuzzard-6641D1A5
kibuzzard-6641D1AA: G***; kibuzzard-6641D1AA
kibuzzard-6641D1B0: G***; kibuzzard-6641D1B0
kibuzzard-6641D19D: G***; kibuzzard-6641D19D
kibuzzard-6642BE6C: G***; kibuzzard-6642BE6C
kibuzzard-6642BE54: G***; kibuzzard-6642BE54
kibuzzard-6642BE85: G***; kibuzzard-6642BE85
kibuzzard-6644A0DC: G***; kibuzzard-6644A0DC
kibuzzard-6644A120: G***; kibuzzard-6644A120
kibuzzard-6644A126: G***; kibuzzard-6644A126
kibuzzard-66458F9C: G***; kibuzzard-66458F9C
kibuzzard-66458F69: G***; kibuzzard-66458F69
kibuzzard-664329E8: G***; kibuzzard-664329E8
kibuzzard-664329F6: G***; kibuzzard-664329F6
kibuzzard-66417165: G***; kibuzzard-66417165
kibuzzard-66417197: G***; kibuzzard-66417197
