rohamid/h743-lcd-dev/(commit log)

2024-05-02 Added UART, i2c, debug, NAND Flash, NOR Flash, EEPROM, SD-Card
    [Display.kicad_sch, H743_LCD_dev.kicad_pcb, H743_LCD_dev.kicad_sch, SDRAM.kicad_sch, STM32H743IIK6.kicad_sch, input-outputs.kicad_sch]
2024-05-02 Added I2S Audio amplifier
    [Display.kicad_sch, H743_LCD_dev.kicad_pcb, H743_LCD_dev.kicad_sch, MAX98357.kicad_sch, SDRAM.kicad_sch, STM32H743IIK6.kicad_sch, input-outputs.kicad_sch]
2024-05-03 Add net class, not clear yet
    [H743_LCD_dev.kicad_pcb]
2024-05-05 Edited PCB
    [H743_LCD_dev.kicad_pcb]
2024-05-10 Finish high speed sdram tracks
    [H743_LCD_dev.kicad_pcb, H743_LCD_dev.kicad_sch, MAX98357.kicad_sch, SDRAM.kicad_sch, STM32H743IIK6.kicad_sch]
2024-05-12 Finish sdram, LCD, SD-card, QSPI, I2S tracks
    [Display.kicad_sch, H743_LCD_dev.kicad_pcb, H743_LCD_dev.kicad_sch, SDRAM.kicad_sch, STM32H743IIK6.kicad_sch, input-outputs.kicad_sch]
2024-05-13 Looks like FPC should be changed to XF2M-4015-1A
    [Display.kicad_sch, H743_LCD_dev.kicad_pcb, H743_LCD_dev.kicad_sch, MAX98357.kicad_sch, SDRAM.kicad_sch, STM32H743IIK6.kicad_sch, input-outputs.kicad_sch]
2024-05-13 Changed the FPC footprint and uart, added RTC battery connector
    [Display.kicad_sch, H743_LCD_dev.kicad_pcb, H743_LCD_dev.kicad_sch, MAX98357.kicad_sch, SDRAM.kicad_sch, STM32H743IIK6.kicad_sch, input-outputs.kicad_sch]
2024-05-14 Added UART esd
    [Display.kicad_sch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]
2024-05-15 All clear (need to verify). LCD backlight driver left untracked
    [H743_LCD_dev.kicad_pcb, H743_LCD_dev.kicad_sch, SDRAM.kicad_sch, STM32H743IIK6.kicad_sch, input-outputs.kicad_sch]
2024-05-15 All clear (need verification), need add capacitor next to I2C conn, verify I2S gain
    [Display.kicad_sch, H743_LCD_dev.kicad_pcb, STM32H743IIK6.kicad_sch]
2024-05-16 Finished. 1st version, ordered 1st batch
    [Display.kicad_sch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]
2024-07-26 Added docs
    [H743_LCD_dev.kicad_pcb, Pin-config.ods]
2024-07-26 Add schematic as pdf
